rnd-ash/ultimate_nag52/images/egs53.jpg

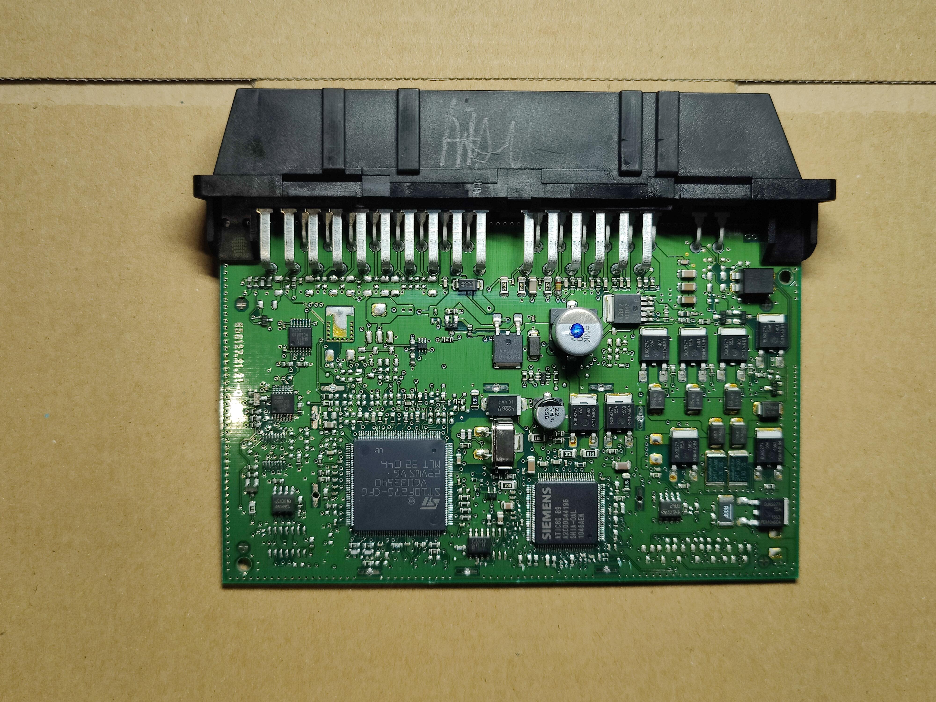
images/egs53.jpg
