rnd-ash/ultimate_nag52/images/egs51.jpg

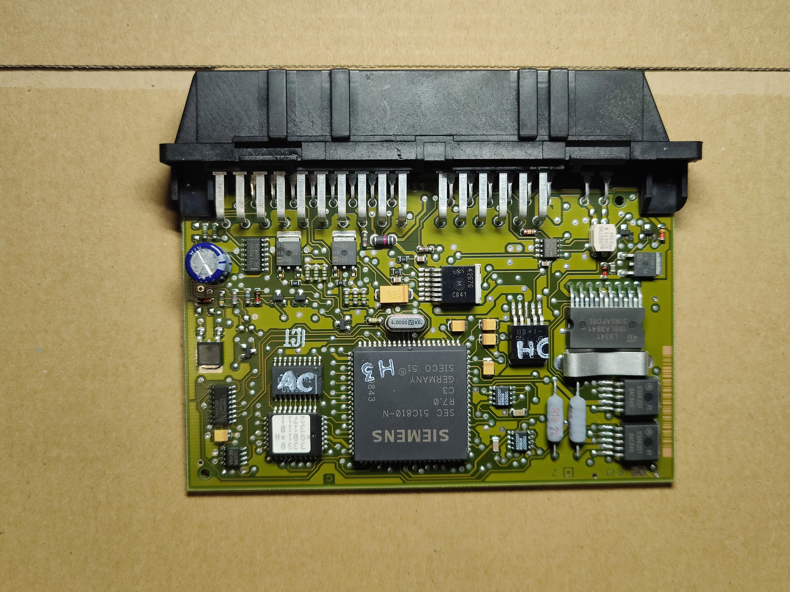
images/egs51.jpg
