rnd-ash/ultimate_nag52/images/egs52.jpg

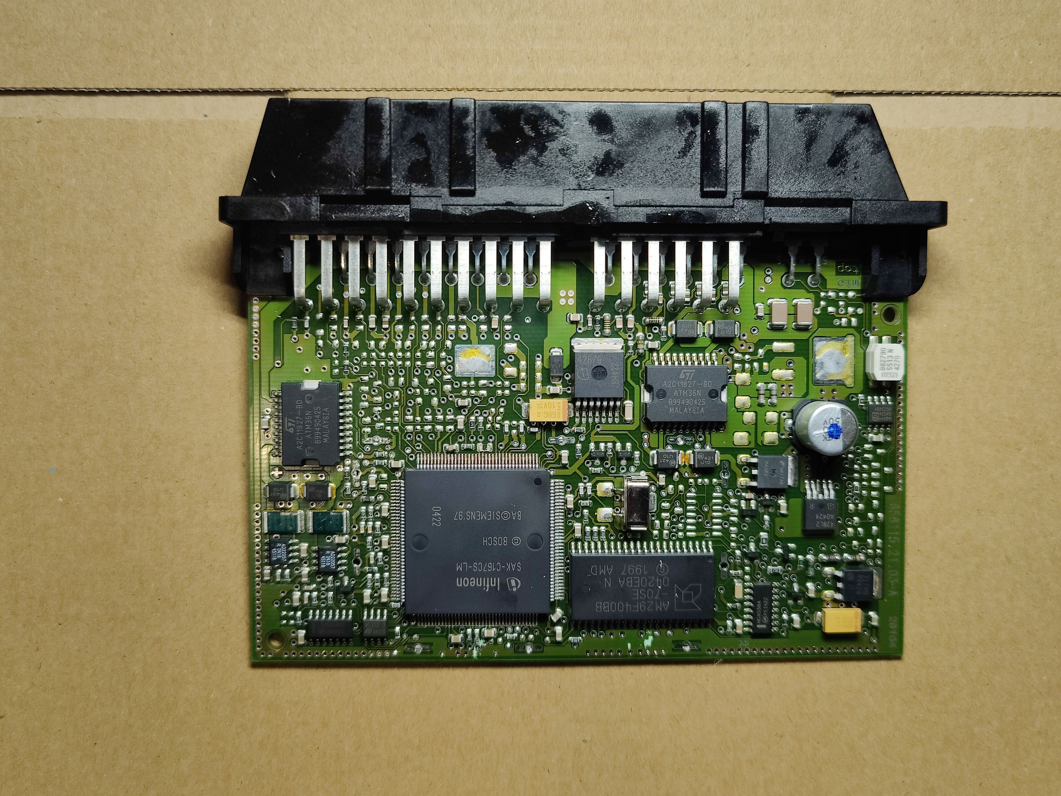
images/egs52.jpg
