rnd-ash/ultimate_nag52/PCB/v1.3 Rev B/bom_v13b.csv

Designator | Footprint | Quantity | Value
C1, C10, C11, C15, C19, C2, C21, C22, C23, C3, C30, C33, C35, C37, C39, C4, C42, C44, C46, C50, C52, C53, C55, C57, C60, C63, C66, C7 | 603 | 28 | 100nF
C12 | CP_Elec_10x10.5 | 1 | 100uF
C13, C16, C24, C51, C58, C8, C9 | 603 | 7 | 10uF
C14, C17, C18, C20 | CP_EIA-3216-18_Kemet-A | 4 | 10uF (Pol.)
C25, C26, C27, C31, C32, C34, C36, C38, C40, C41, C43, C45, C47, C48 | 603 | 14 | 1nF
C28, C29, C49, C54, C56, C59, C62, C65 | 603 | 8 | 10nF
C5, C6 | 603 | 2 | 15pF
D1, D3 | 805 | 2 | LED
D10, D11, D12, D16, D17, D18, D19, D8, D9 | D_SMA | 9 | SS56
D13 | SOT-23 | 1 | BZX84C43
D14 | SOT-23 | 1 | BAV70
D15 | SOT-23 | 1 | BZX84C8V2
D2, D4 | 805 | 2 | LED
D5 | SOT-23 | 1 | BAS40-04
D6 | D_SOD-123 | 1 | BZT52C3V9
D7 | D_SOD-123 | 1 | BZT52C5V6
FL1 | L_CommonModeChoke_TDK_ACM7060 | 1 | SMCM7060-501T
J1 | USB_C_Receptacle_G-Switch_GT-USB-7010ASV | 1 | TYPE-C 16PIN 2MD(073)
J2, J3, J4 | PinHeader_1x03_P2.54mm_Vertical | 3 | Conn_01x03_Pin
LS1 | SFN-12055P | 1 | Speaker
Q1, Q12, Q2 | SOT-23 | 3 | BC817-40
Q10, Q11, Q13, Q14, Q15, Q16, Q6, Q7, Q8, Q9 | TDSON-8-1-thermal-vias | 10 | BSC0702LS
Q3, Q4, Q5 | SOT-23 | 3 | 2N7002
R1, R11, R12, R16, R18, R19, R2, R24, R25, R26, R27, R28, R3, R30, R32, R34, R36, R37, R4, R40, R41, R43, R44, R45, R48, R5, R52, R53, R54, R56, R58, R6, R60, R7 | 603 | 34 | 10K
R10 | 603 | 1 | 22k
R13, R14 | 603 | 2 | 5.1k
R15 | 805 | 1 | 120
R17 | 603 | 1 | 2.2k
R20, R23, R39, R51, R9 | 603 | 5 | 2k
R29, R31, R33, R35, R38, R42 | 603 | 6 | 3k
R46, R47, R55, R57, R59, R61 | 2512 | 6 | 10mΩ
R49, R50 | 603 | 2 | 1K
R8 | 603 | 1 | 47k
SW1 | SW_SPST_TS-1088-xR020 | 1 | TS-1088-AR02016
U1 | TSSOP-24_4.4x7.8mm_P0.65mm | 1 | PCA9535PW,118
U10, U11, U12, U13, U14, U9 | SOT-23-5 | 6 | INA180A3IDBVR
U15 | SOT-23-5 | 1 | AP2112K-3.3
U2 | QFN-24-1EP_4x4mm_P0.5mm_EP2.6x2.6mm | 1 | CP2102N-A02-GQFN24R
U3 | SOT-23-6 | 1 | SRV05-4
U4 | SOIC-8_3.9x4.9mm_P1.27mm | 1 | SN65HVD230
U5 | SOT-223-3_TabPin2 | 1 | AMS1117-3.3
U6 | TO-252-2 | 1 | L78M05ABDT-TR
U7 | ESP32-WROVER-E | 1 | ESP32-WROVER-E-N8R8
U8 | Connector | 1 | connector
