rnd-ash/ultimate_nag52/PCB/v1.3/BOM_1_3.xlsx

Item | Qty | Reference(s) | #manf | Value
1 | 16 | C1, C2, C3, C6, C7, C8, C9, C13, C23, C24, C25, C26, C27, C28, C29, C30 | CC0603KRX7R9BB104 | 100nF
2 | 2 | C4, C5 | CL10B102KB8NNNC | 1nF
3 | 3 | C10, C11, C12 | CL31A106KBHNNNE | 10uF
4 | 2 | C14, C15 | GRM21BR61H106KE43L | 10uF
5 | 2 | C16, C17 | 0603B103K500NT | 10nF
6 | 2 | C18, C20 | TAJA476K006RNJ | 47uF
7 | 2 | C19, C21 | TAJB336K016RNJ | 33uF
8 | 6 | C31, C32, C33, C34, C35, C36 | CL10B223KB8NNNC | 22nF
9 | 2 | D1, D2 | BAS40-04 | BAS40-04
10 | 9 | D3, D4, D5, D11, D12, D13, D14, D15, D16 | 1SMA4753_R1_00001 | 1SMA4753
11 | 1 | D6 | SP0505BAHTG | SP0505BAHT
12 | 3 | D7, D18, D24 | VLMTG1300-GS08 | LED
13 | 1 | D17 | NCD0603O2 | LED
14 | 5 | D8, D19, D20, D22, D23 | E6C0603VGAC1UDA | LED
15 | 1 | D21 | NCD0603B4 | LED
16 | 2 | D9, D10 | SS54 | D_Schottky
17 | 1 | FL1 | ACT1210-101-2P-TL00 | ACT1210-101-2P-TL00
18 | 1 | IC1 | MAX3051ESA+T | MAX3051ESA+T
19 | 1 | IC2 | PCA9535PW,118 | PCA9535PW,118
20 | 2 | J1, J2 |  | Conn_01x03
21 | 2 | L1, L2 | FNR5020S101MT | 100uH
22 | 1 | LS1 | SFN-12055PA6.5 | Speaker
23 | 1 | Q1 | MMBT3904 | MMBT3904
24 | 9 | Q2, Q3, Q4, Q6, Q7, Q8, Q9, Q10, Q11 | IPD031N03LGATMA1 | IPD031N03LGATMA1
25 | 1 | Q5 | UMH3N | UMH3N
26 | 1 | R1 |  | 120
27 | 1 | R2 | AECR0603F1K00K9 | 1K
28 | 22 | R3, R5, R6, R7, R8, R9, R10, R11, R18, R19, R20, R21, R23, R28, R29, R30, R34, R35, R36, R37, R38, R43 | 0603WAF1002T5E | 10K
29 | 1 | R4 | 0603WAF2201T5E | 2.2K
30 | 2 | R12, R15 | 0603WAF2001T5E | 2K
31 | 1 | R13 | CR0603FA2212G | 22.1K
32 | 1 | R14 | 0603WAF4752T5E | 47.5K
33 | 2 | R16, R17 | ERA3AED512V | 5.1K
34 | 1 | R22 | CR0603-FX-5901ELF | 5.9k
35 | 1 | R24 | CR0603-FX-3241ELF | 3.24k
36 | 6 | R25, R26, R27, R31, R32, R33 | LR122WF100MT4E | 0.01
37 | 4 | RN1, RN3, RN5, RN6 | 4D03WGJ0103T5E | 10K
38 | 2 | RN2, RN4 | 4D03WGJ0302T5E | 3K
39 | 1 | SW1 | PTS810SJG250SMTRLFS | SW_DIP_x01
40 | 1 | U1 |  | connector
41 | 1 | U2 | ESP32-WROVER-I | ESP32-WROVER-E
42 | 1 | U3 | CP2102N-A02-GQFN24 | CP2102N-Axx-xQFN24
43 | 1 | U4 | TPAP2112K-3.3TRG1 | AP2112K-3.3
44 | 2 | U5, U6 | TPS5430DDAR | TPS5430DDA
45 | 6 | U7, U8, U9, U10, U11, U12 | INA180A3IDBVR | INA180A3
46 | 1 | USB1 | TYPE-C-2.0-16PIN-SMT-3 | HRO-TYPE-C-31-M-12
