rnd-ash/ultimate_nag52/Addon Boards/1.3 Tcc Zener mod/bom.csv

ID | Name | Designator | Footprint | Quantity | Manufacturer Part | Manufacturer | Supplier | Supplier Part | Price | Pins | 3DModel | Contributor | JLCPCB Part Class | link
1 | 10kΩ | R1,R2 | R0603 | 2 | 0603WAF1002T5E | UNI-ROYAL(厚声) | LCSC | C25804 | 0.001 | 2 | R0603 | lcsc | Basic Part | https://www.mouser.in/datasheet/2/447/PYu_RT_1_to_0_01_RoHS_L_11-1669912.pdf
2 | 1kΩ | R3,R4 | R0603 | 2 | 0603WAF1001T5E | UNI-ROYAL(厚声) | LCSC | C21190 | 0.001 | 2 | R0603 | lcsc | Basic Part | https://www.mouser.in/datasheet/2/447/PYu_RT_1_to_0_01_RoHS_L_11-1669912.pdf
3 | 2kΩ | R5 | R0603 | 1 | 0603WAF2001T5E | UNI-ROYAL(厚声) | LCSC | C22975 | 0.001 | 2 | R0603 | lcsc | Basic Part | https://www.mouser.in/datasheet/2/447/PYu_RT_1_to_0_01_RoHS_L_11-1669912.pdf
4 | BZX84C43 | D4 | SOT-23_L2.9-W1.3-P1.90-LS2.4-BR | 1 | BZX84C43 | ST(先科) | LCSC | C118590 | 0.021 | 3 | SOT-23-3P_L2.9-W1.3-H1.0-LS2.4-P0.95 | LCSC | Extended Part | https://item.szlcsc.com/236142.html
5 | BZX84C8V2_C20616331 | U16 | SOT-23_L2.9-W1.3-P1.90-LS2.4-BR | 1 | BZX84C8V2 | HXY MOSFET(华轩阳电子) | LCSC | C20616331 | 0.014 | 3 | SOT-23-3P_L2.9-W1.3-H1.0-LS2.4-P0.95 | lcsc | Extended Part | https://item.szlcsc.com/236142.html
6 | 1SMA4753A_C438371 | D5 | SMA_L4.3-W2.5-LS5.0-RD | 1 | 1SMA4753A | 晶导微电子 | LCSC | C438371 | 0.032 | 2 | SMA_L4.3-W2.5-LS5.0-RD | LCSC | Extended Part | https://atta.szlcsc.com/upload/public/pdf/source/20191021/C437786_3D65CEC0912CC3CA85CA024EBEBBFCE4.pdf
7 | IPD031N03LGATMA1 | U12,U13 | TO-252-2_L6.5-W6.1-P4.56-LS9.9-BR-CW-1 | 2 | Infineon | Infineon | LCSC |  |  | 3 |  | lcsc | Extended Part | https://img.jlc.com/pdf/applyPasteComponent/2021-11-03/119727G/d1c2bc415c4146f883da2df02eb0e505/IRFR9024N.pdf
8 | BAV70_C2841895 | U14 | SOT-23-3_L2.9-W1.4-P1.90-LS2.6-BR | 1 | BAV70 | KODENSHI AUK(光电子) | LCSC | C2841895 | 0.014 | 3 | SOT-23-3_L2.9-W1.4-P1.90-LS2.6-BR | lcsc | Extended Part | https://lcsc.com/eda_search?q=C2841895&%26type=1&ref=editor
9 | 54102-T06-00 | U15,U18,U19,U20,U21 | HDR-TH_1P-P2.54-V-M | 5 | 54102-T06-00 | Amphenol | LCSC | C213182 | 0.02 | 1 | HDR2.54-M-LI-1X1P | LCSC |  | https://item.szlcsc.com/82426.html
10 | 100nF | U17 | C0603 | 1 | FN18X104J500PBG | PSA(信昌电陶) | LCSC | C2836871 | 0.005 | 2 | C0603_L1.6-W0.8-H0.8 | lcsc | Extended Part | https://lcsc.com/eda_search?q=C2836871&%26type=1&ref=editor
11 | BC817-40_C7528930 | U22 | SOT-23-3_L2.9-W1.3-P1.90-LS2.4-BR | 1 | BC817-40 | AM(安美) | LCSC | C7528930 | 0.014 | 3 | SOT-23-3P_L2.9-W1.3-H1.0-LS2.4-P0.95 | lcsc | Extended Part | https://www.diodes.com/assets/Package-Files/SOT23.pdf
