rnd-ash/ultimate_nag52/Addon Boards/1.3 Tcc Zener mod/mount_model.stl

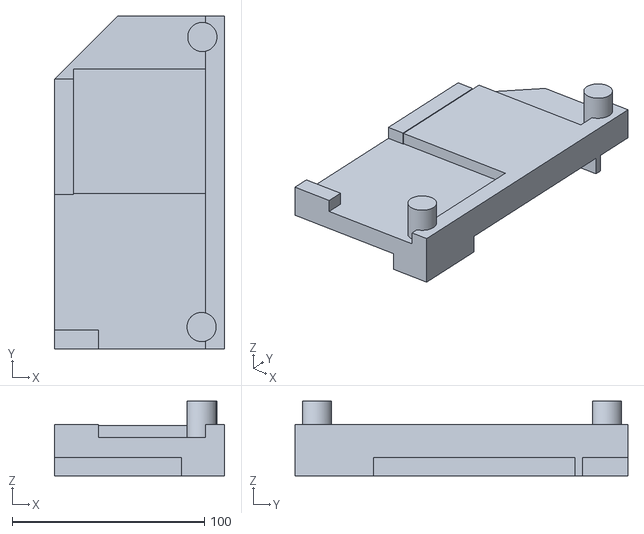
[picture p4: CAD file, 2024-10-16]
Addon Boards/1.3 Tcc Zener mod/mount_model.stl
88.6 x 173.4 x 39.0
