rnd-ash/ultimate_nag52/case_models/case_v3.stl

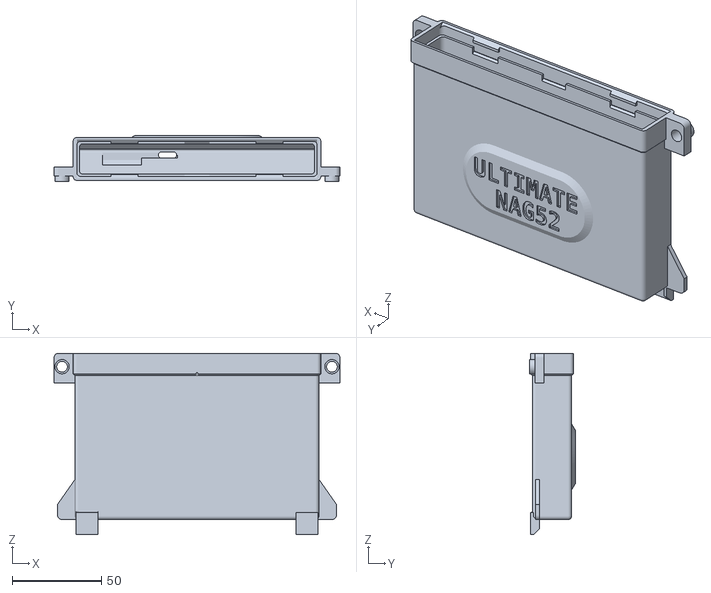
[picture p5: CAD file, 2024-05-09]
case_models/case_v3.stl
160.0 x 25.5 x 101.5
