rnd-ash/ultimate_nag52/(threads)

Thread 1 (2021-02-19):

For what kind of Vehicle this CAN frames code?

iDoka, 2021-02-19:
I would like to add your repo in my collection:
https://github.com/iDoka/awesome-automotive-can-id

Which one Vendor and model related to your code?

rnd-ash, 2021-02-19:
I see you are already have my W203-canbus project.

This is for the same vehicle, so should theoretically work on W203/w209/w211/w219 vehicles.

Check my mbux_port repository for more can data.

iDoka, 2021-02-20:
Ashcon,
thanks for sharing detail!

Closed 2021-02-20.

Thread 2 (2021-12-25):

What does "open implementation" mean as of today?

rusefillc, 2021-12-25:
I was able to find schematics PDF and firmware source code

what is the URL for PCB source? is there a URL for gerbers/bom?

rnd-ash, 2021-12-26:
Currently the BOM / PCB design is private. And I think I will keep it that way for now. This is to ensure people don't make their own PCB designs, run my code on it and then complain when something doesn't work. (I can guarantee assembled units will work so that hopefully eliminates a potential point of failure).

"Open" in this case simply refers to the source code and schematics of the board.

Thread 6 (2022-04-09):

does SH8KA4TB1 need a diode to drive solenoids?

rusefillc, 2022-04-09:
Do you have/need flyback (?) diodes if using SH8KA4TB1 to drive solenoids?

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

rnd-ash, 2022-04-10:
This doesn't look like my tcm, rather I think the one in your image is SSCG's one (standalone without can)

That said, my circuits use a MOSFET and diode, using the exact same setup as the OEM EGS53 TCM (even as far as to use the same automotive grade BUK9277 MOSFETs) . Electrically, it is extremely stable at any pwm (0-4096), and I have not noticed any issues with this circuit in my board I've been using for just under a year now.

rusefillc, 2022-04-10:
Oooops :)

Closed 2022-04-10.

Thread 7 (2022-05-10):

config_app unable to compile

borgonzola, 2022-05-10:
Compiling ecu_diagnostics v0.90.33
error[E0432]: unresolved import `j2534_rust::Loggable`
  --> /home/user/.cargo/registry/src/github.com-1ecc6299db9ec823/ecu_diagnostics-0.90.33/src/hardware/passthru/mod.rs:36:40
   |
36 |     ConnectFlags, FilterType, IoctlID, Loggable, PassthruError, Protocol, RxFlag, TxFlag,
   |                                        ^^^^^^^^ no `Loggable` in the root

   This issue also appears trying to build cloned ecu_diagnostics.

rnd-ash, 2022-05-10:
fixed and closed

Closed 2022-05-10.

Thread 8 (2022-06-09):

A few questions

rocketbob, 2022-06-09:
Interested in using this on my Porsche 996 C4 with 722.6 tiptronic.

What's the timeline for releasing the gerbers?

The current TCU uses an 88 pin connector.  Thoughts on either a breakout board/adapter or an alternate board design with the 88 pin connector footprint added to the PCB?

Thanks
Bob

rocketbob, 2022-06-10:
I believe its a Bosch TCM with a standard Motronic connector.  The upshift/downshift switches connect to the TCM and the gear position is relayed back to the gauge cluster via CAN.

The pinout of the 88 pin connector starts on page 8 of the attached PDF.

[996Tiptronic.pdf](https://github.com/rnd-ash/ultimate_nag52/files/8878836/996Tiptronic.pdf)

rocketbob, 2022-06-27:
I'm certain its a 722.6 as its a 2003 with a 3.6L motor.  ZF versions only shipped with 3.4L motors.  There are Mercedes logos in the castings.

rnd-ash, 2022-06-27:
Well then you have certainly found the wrong ECU. 722.6 ONLY ever comes with a Simens ECU, no other vendor makes the TCM for it, no matter the vehicle.

rnd-ash, 2022-06-27:
Actually, one thing you could potentially do is to check the transmission plug style. It is possible that they have put the internals of the ZF box in the 722.6 casing (Or a common casing). The plug should be able to verify what box you have.

As per what you sent, the ZF box should have a connector like this:
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

Where as the 722.6's connect is as follows:
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

you can see they are completely different connector pin setup

rocketbob, 2022-06-28:
Heres's a photo of the transmission when I had the motor out of the car.  On the side it clearly says Mercedes Benz.

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
.

stukodotnet, 2022-07-05:
Thats the 722.6 connector just above the half-shaft flange. With the off-white/yellowed plastic ring around it.  I don't know anything about the "Tiptronic" other than it did use a 722.6 but it drives it in a semi-auto way. So it could possibly have a different TCU than the Siemens. Can you trace that piece of loom back to the TCU in the car?

ooojupel, 2023-12-01:
Hello. I own an old w124 with OM606 turbodiesel with mechanical IP. Currently installed 722.6 on the Ole Fejer controller (with egs 51 non can shifter). I really want to try your controller for some reasons, if is it possible to add an analog input for signals of engine speed, throttle position, temperature? As i can see, there is free IO 1_3-IO1_7 GPIO Expander inputs, or it for discret signal and esp32 have free gpio too? I can make the PCB myself.
My car has abs (esp) W203 the same like crossfire, W209, with egs52 layer, but not connected by CAN, only abs function. Is it possible to also add an engine identifier to CAN for ESP operation?

Thread 10 (2022-07-10):

Stand Alone TCU?

GreJef04, 2022-07-10:
I am interested in using this as a stand alone for swapping a 722.6 into my W124 with an OM606. Is this a viable option?

I realize, usually there is some fuelling cut that goes on between shifts to make it easier on the transmission. How hard would it be to allow the TCU to operate as a boost controller as well? If I could get it to read boost, and modulate a couple vacuum solenoids it could modulate the fuelling to allow for cleaner shifts. Obviously the W124 is not an OBD2 vehicle.

GreJef04, 2022-07-10:
Just read through your FAQs. Nope, it's not viable as a stand alone for anyone else who comes along.

Closed 2022-07-10.

Thread 14 (2022-12-18):

Missing part.

Horiibence, 2022-12-18:
Hi,
i looking for a part like this to my PCB, but i can't find an alternative part. Can you help me found one. Thank you so much!
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

Closed 2022-12-25.
