rnd-ash/ultimate_nag52/PCB/v1.3 Rev B/schematics_v13b.pdf

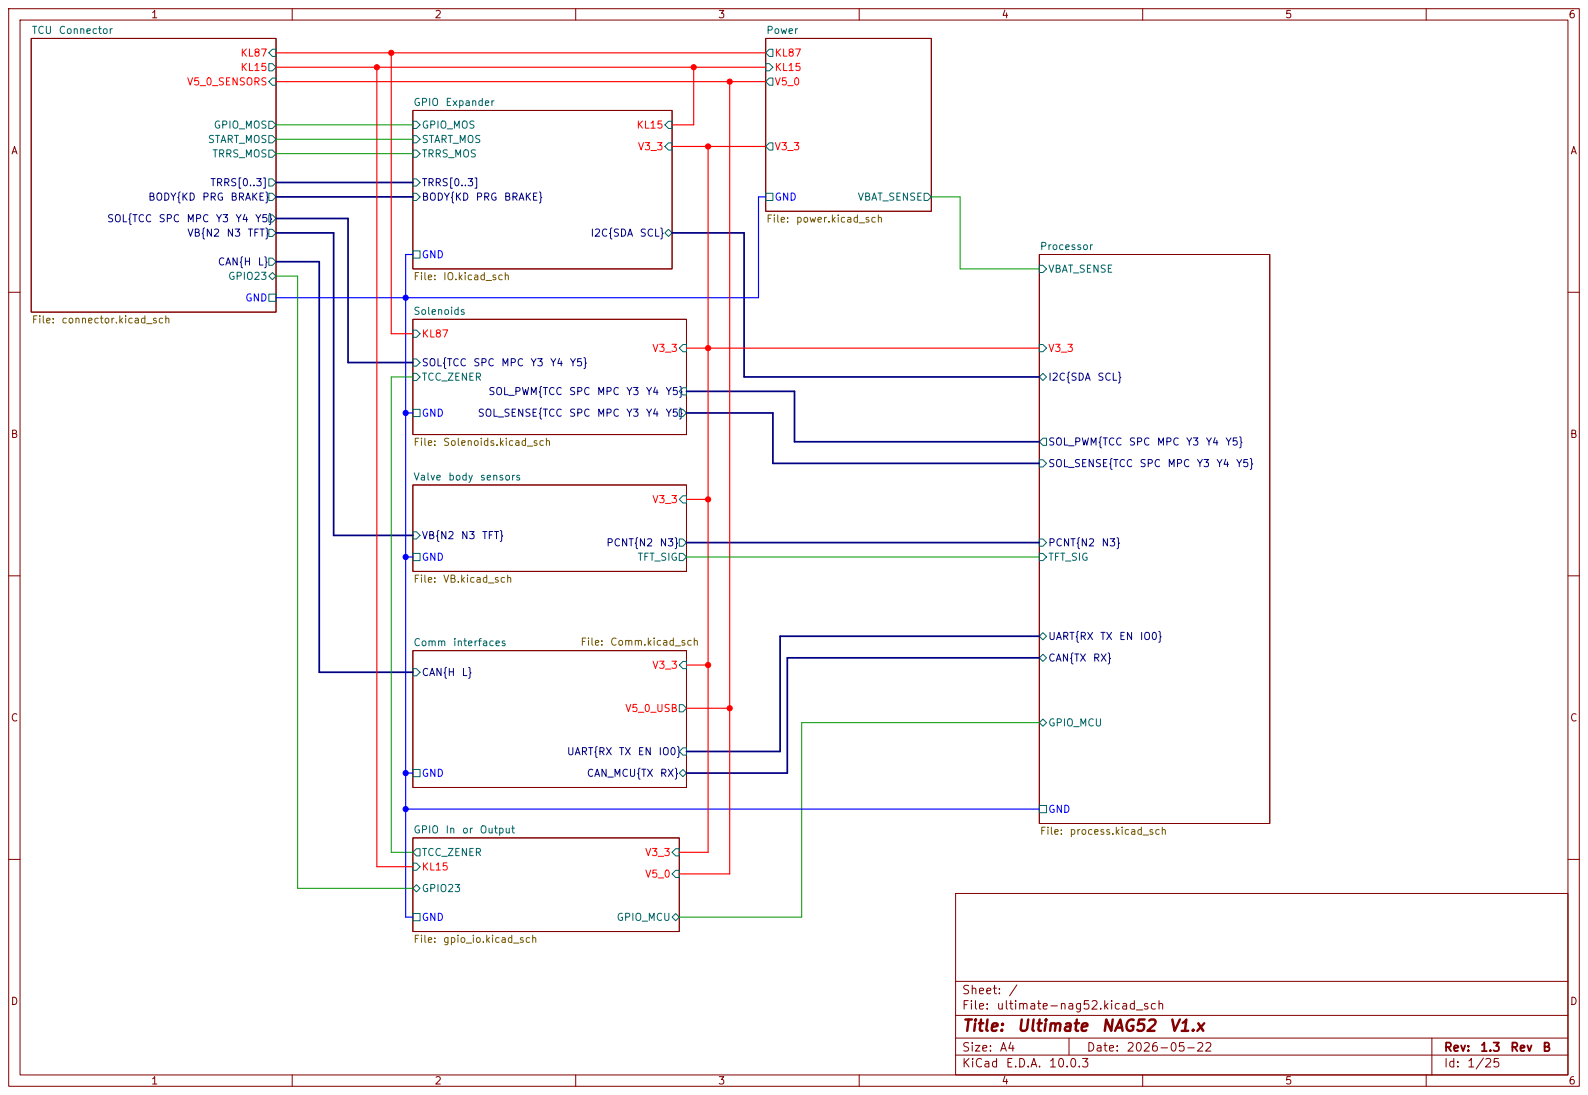
[picture p6: page 1]

V5_0_SENSORS KL15 GPIO23 GPIO_MOS
TRRS[0..3] GPIO Expander File: IO.kicad_sch CAN{H L} GND

TRRS_MOS BODY{KD PRG BRAKE}

SOL{TCC SPC MPC Y3 Y4 Y5}

SOL_SENSE{TCC SPC MPC Y3 Y4 Y5} TFT_SIG UART{RX TX EN IO0} VBAT_SENSE Processor File: process.kicad_sch GND
GND

Solenoids File: Solenoids.kicad_sch GND

SOL{TCC SPC MPC Y3 Y4 Y5} TCC_ZENER

V5_0_USB UART{RX TX EN IO0}

GPIO In or Output File: gpio_io.kicad_sch

Size: A4 | Rev: 1.3 Rev B
KiCad E.D.A. 10.0.3 | Id: 1/25

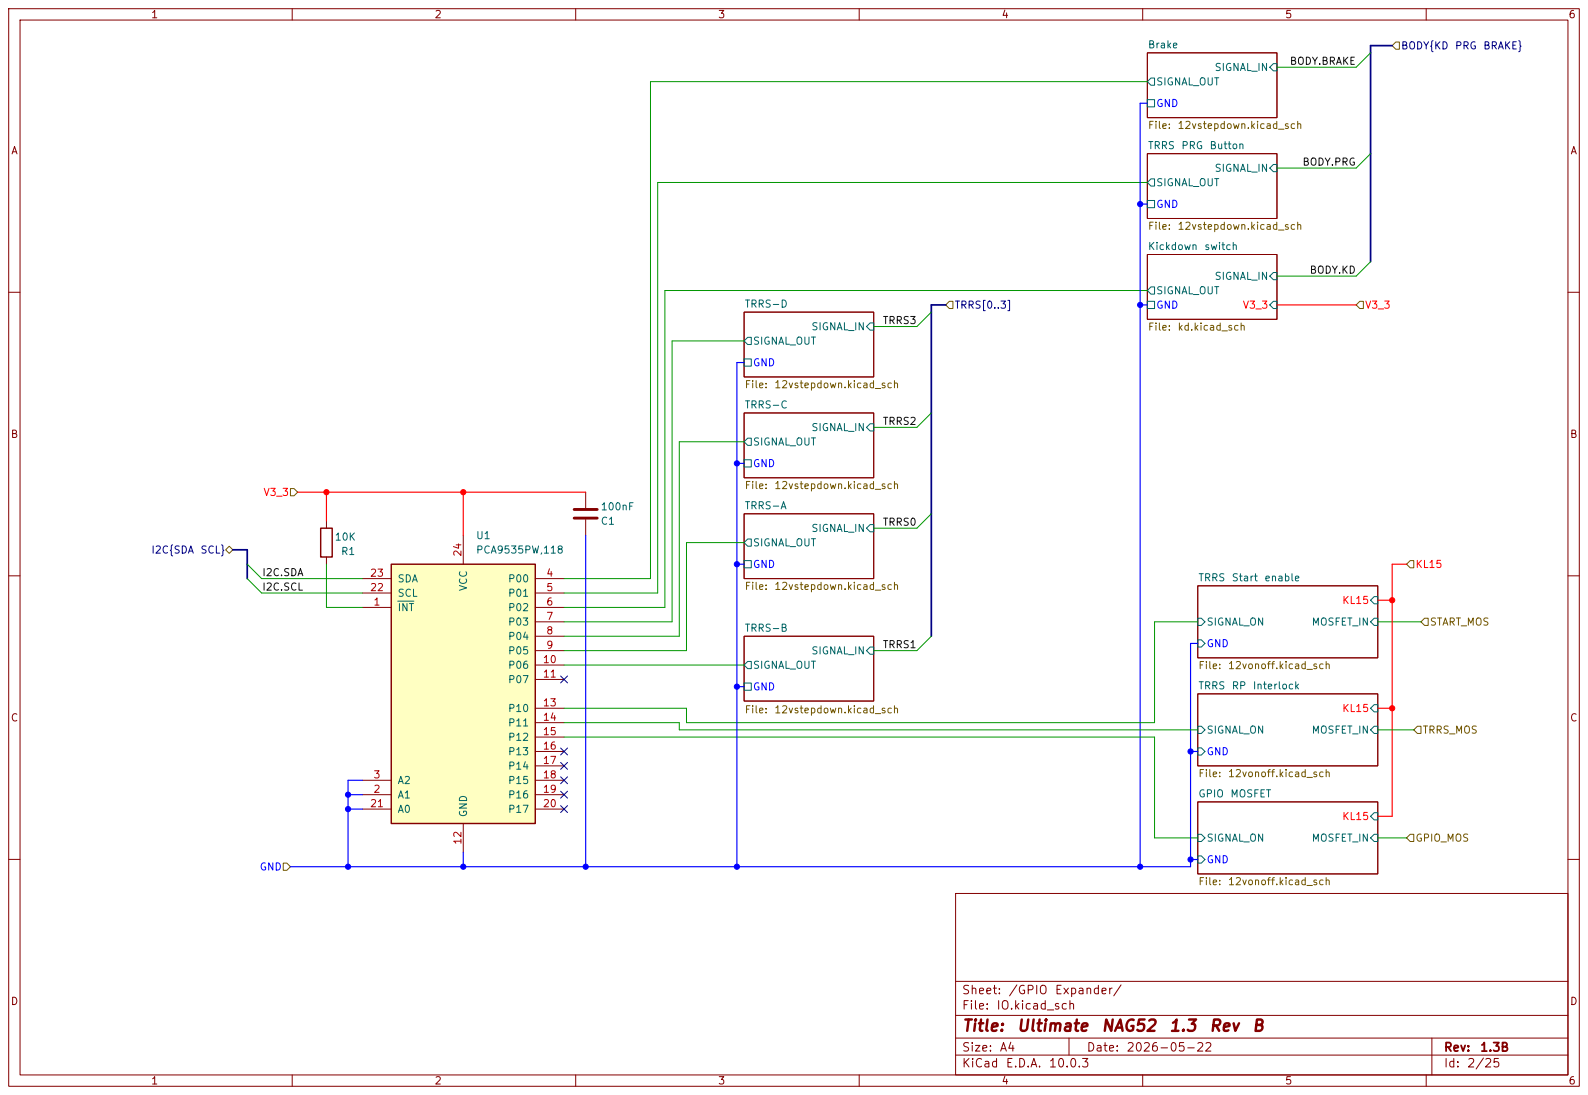
[picture p7: page 2]

BODY{KD PRG BRAKE}

TRRS RP Interlock File: 12vonoff.kicad_sch GND

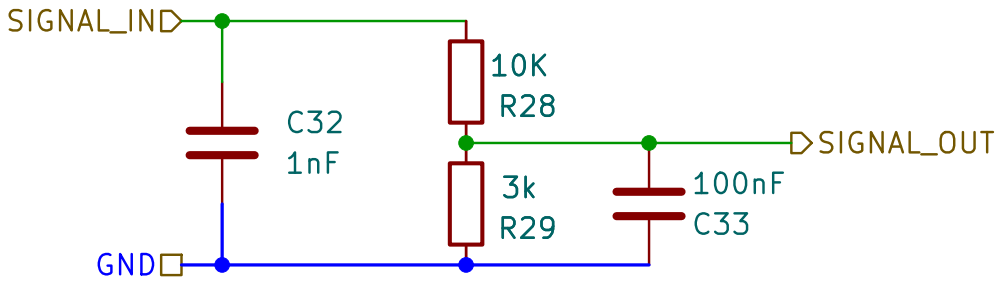
[picture p8: page 3]

Sheet: /GPIO Expander/TRRS-A/
File: 12vstepdown.kicad_sch
Title: Ultimate NAG52 1.3 Rev B

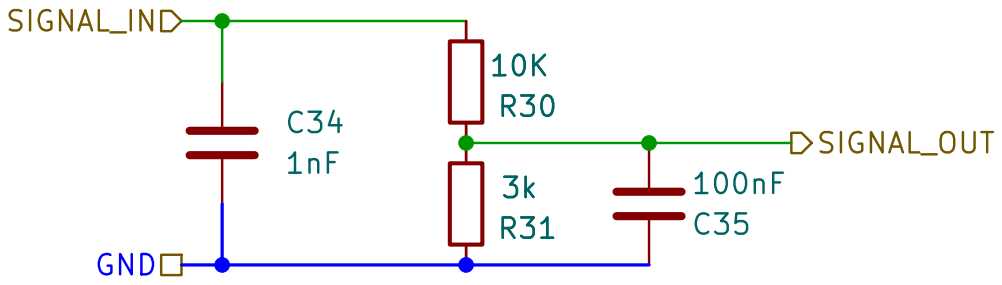
[picture p9: page 4]

Sheet: /GPIO Expander/TRRS-B/
File: 12vstepdown.kicad_sch
Title: Ultimate NAG52 1.3 Rev B

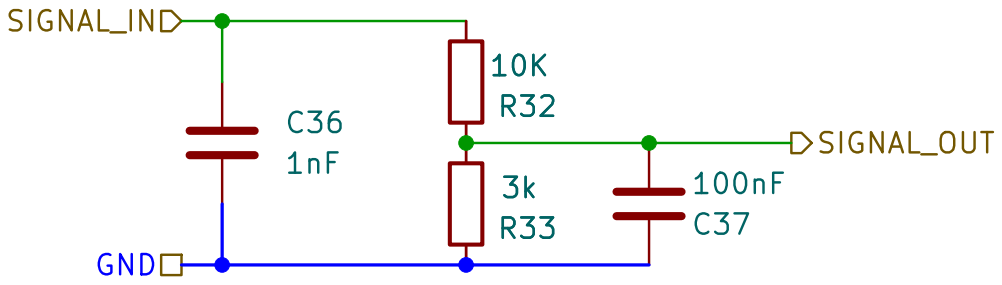
[picture p10: page 5]

Sheet: /GPIO Expander/TRRS-C/
File: 12vstepdown.kicad_sch
Title: Ultimate NAG52 1.3 Rev B

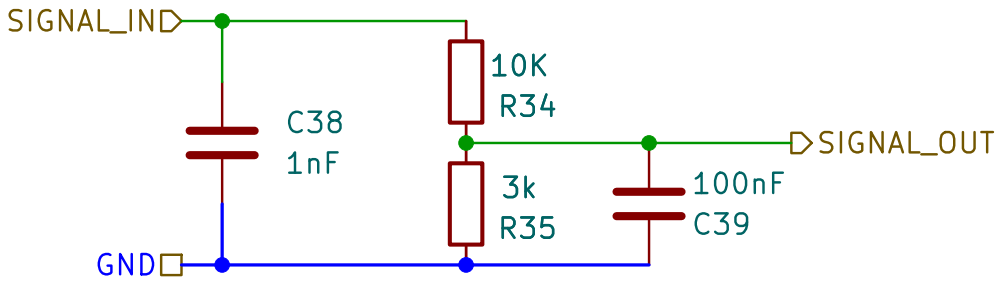
[picture p11: page 6]

Sheet: /GPIO Expander/TRRS-D/
File: 12vstepdown.kicad_sch
Title: Ultimate NAG52 1.3 Rev B

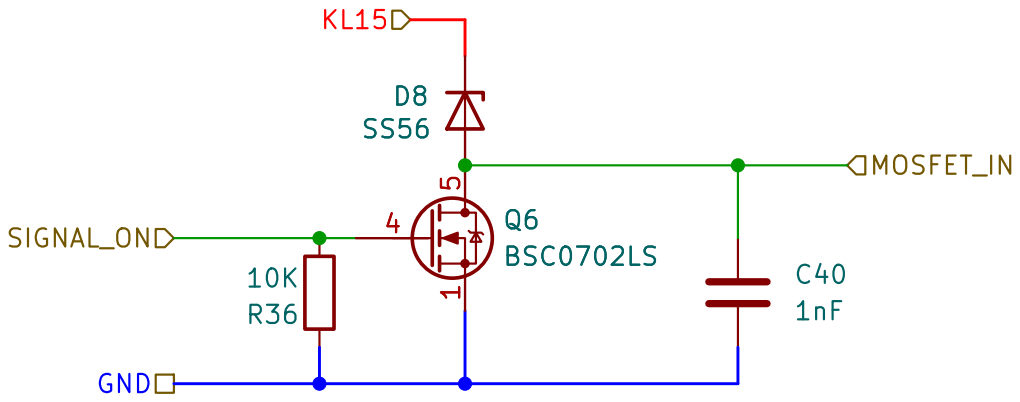
[picture p12: page 7]

Sheet: /GPIO Expander/TRRS Start enable/
File: 12vonoff.kicad_sch
Title: Ultimate NAG52 1.3 Rev B

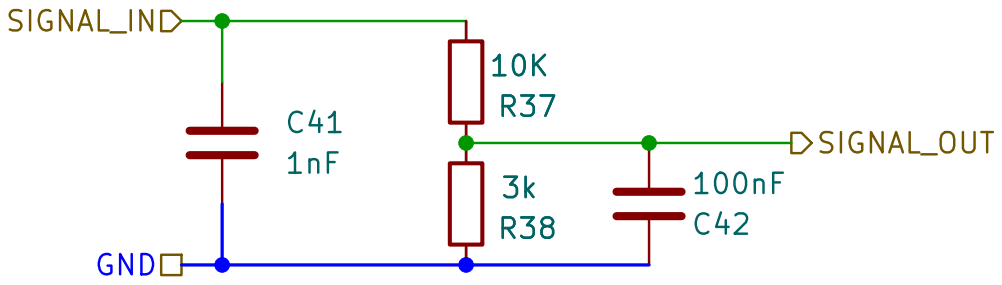
[picture p13: page 8]

Sheet: /GPIO Expander/Brake/
File: 12vstepdown.kicad_sch
Title: Ultimate NAG52 1.3 Rev B

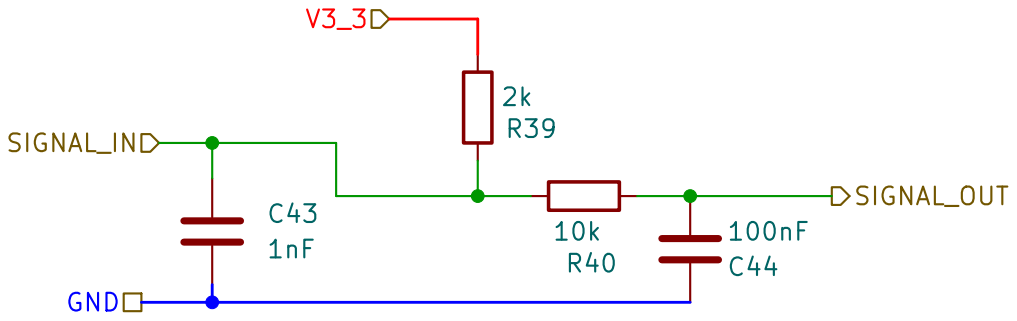
[picture p14: page 9]

Sheet: /GPIO Expander/Kickdown switch/
File: kd.kicad_sch
Title: Ultimate NAG52 1.3 Rev B

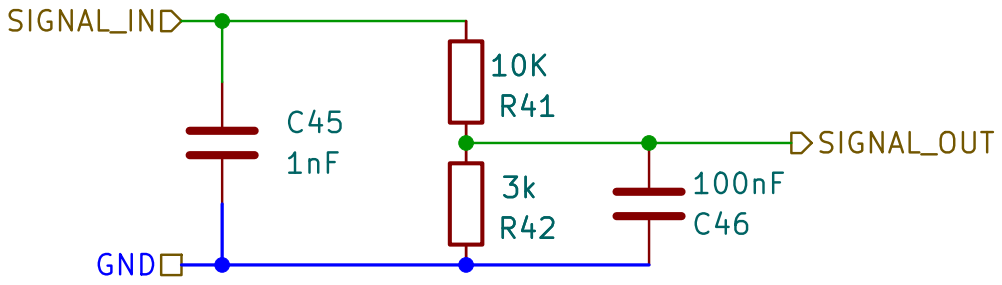
[picture p15: page 10]

Sheet: /GPIO Expander/TRRS PRG Button/
File: 12vstepdown.kicad_sch
Title: Ultimate NAG52 1.3 Rev B

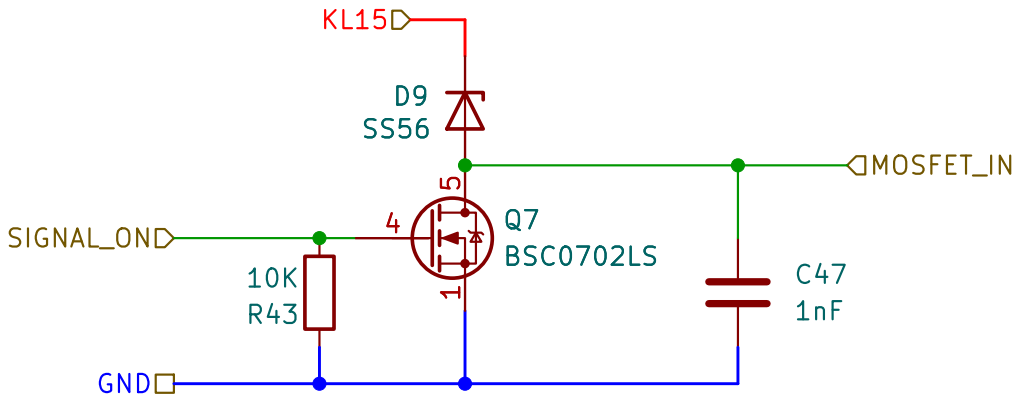
[picture p16: page 11]

Sheet: /GPIO Expander/GPIO MOSFET/
File: 12vonoff.kicad_sch
Title: Ultimate NAG52 1.3 Rev B

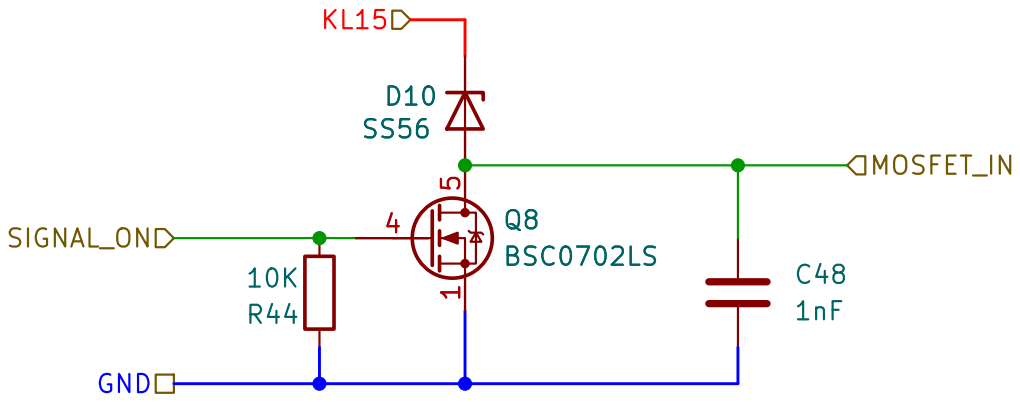
[picture p17: page 12]

Sheet: /GPIO Expander/TRRS RP Interlock/
File: 12vonoff.kicad_sch
Title: Ultimate NAG52 1.3 Rev B

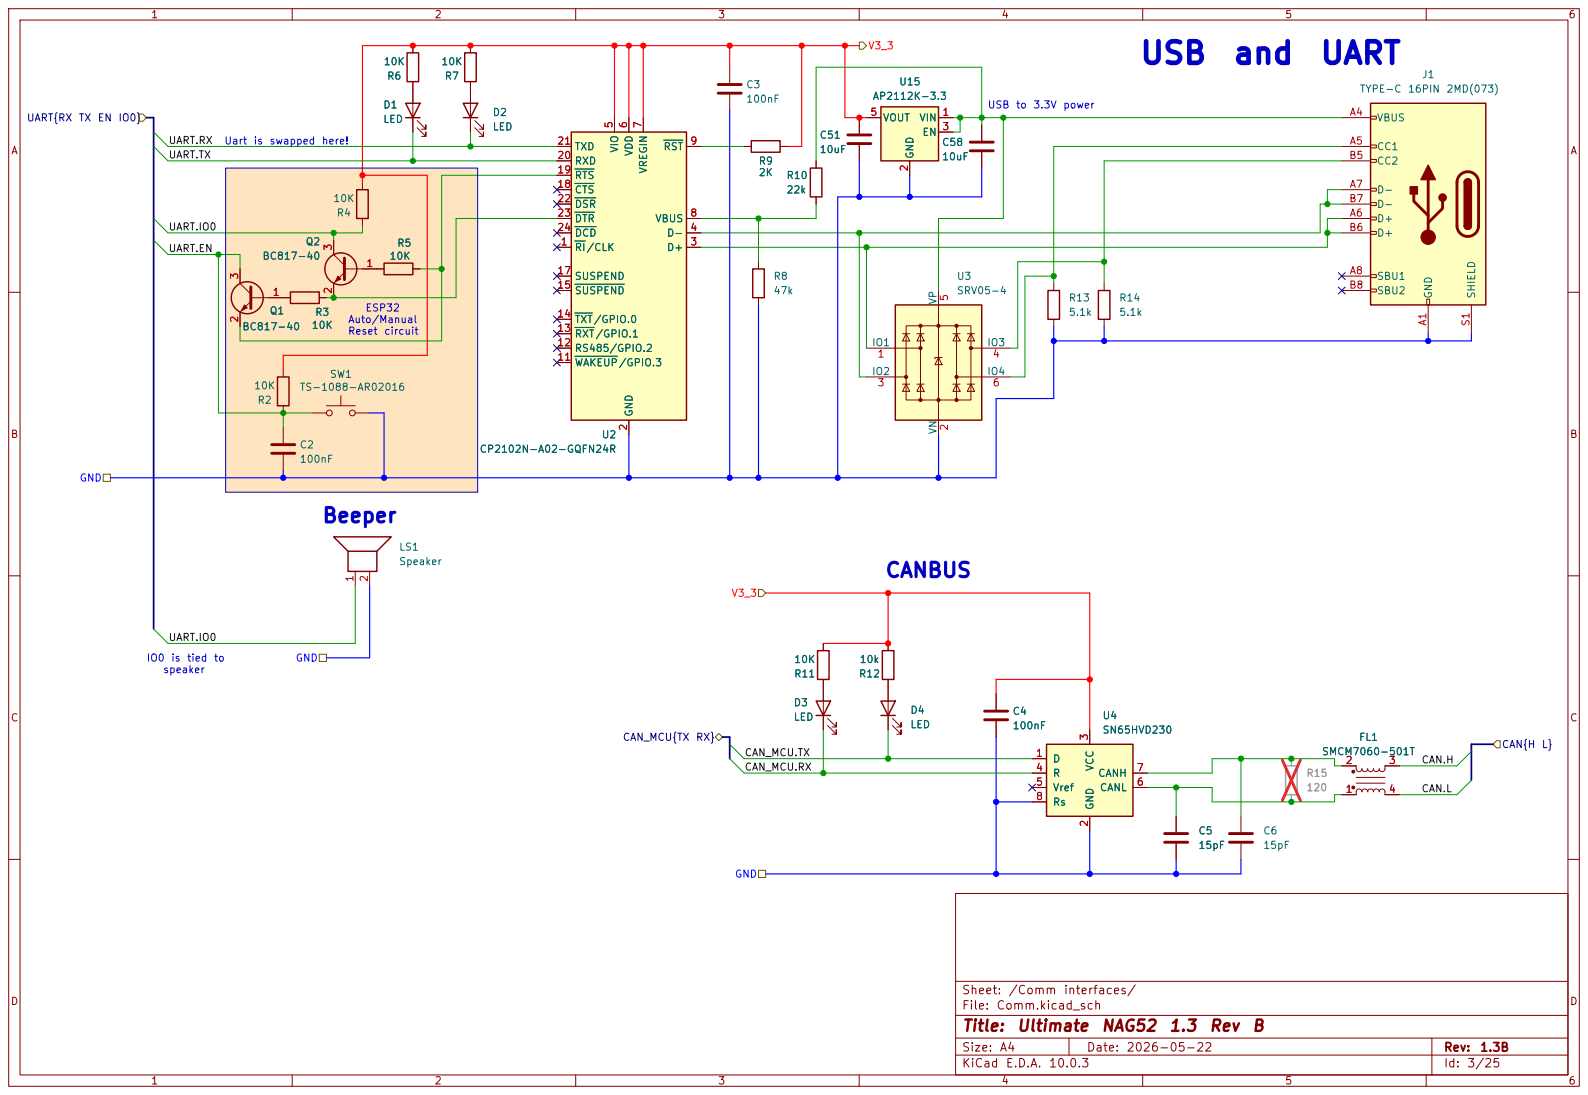
[picture p18: page 13]

SUSPEND 15 SUSPEND 17 CTS 18 RTS 19 RXD 20 TXD 21 DSR 22 DTR 23 DCD 24 R6

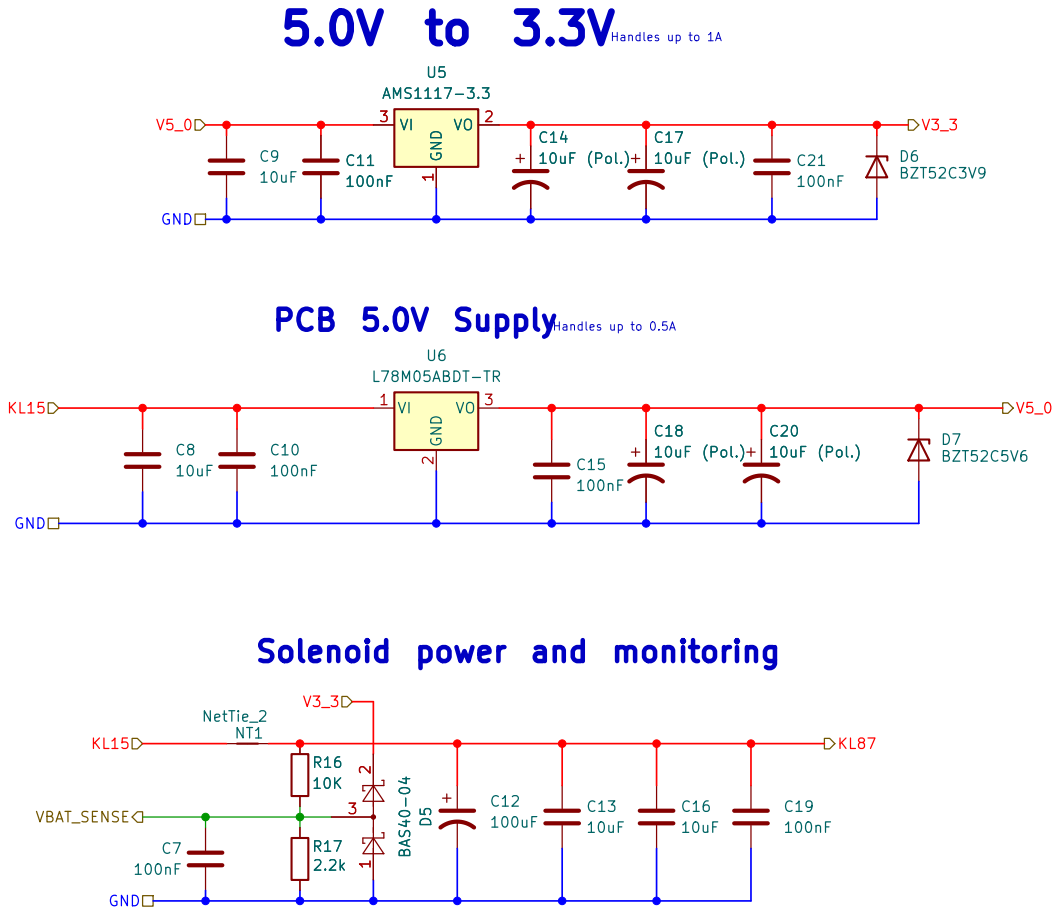
[picture p19: page 14]

PCB 5.0V SupplyHandles up to 0.5A Handles up to 1A Solenoid power and monitoring
AMS1117-3.3 R17
10uF (Pol.) R17
V3_3 GND

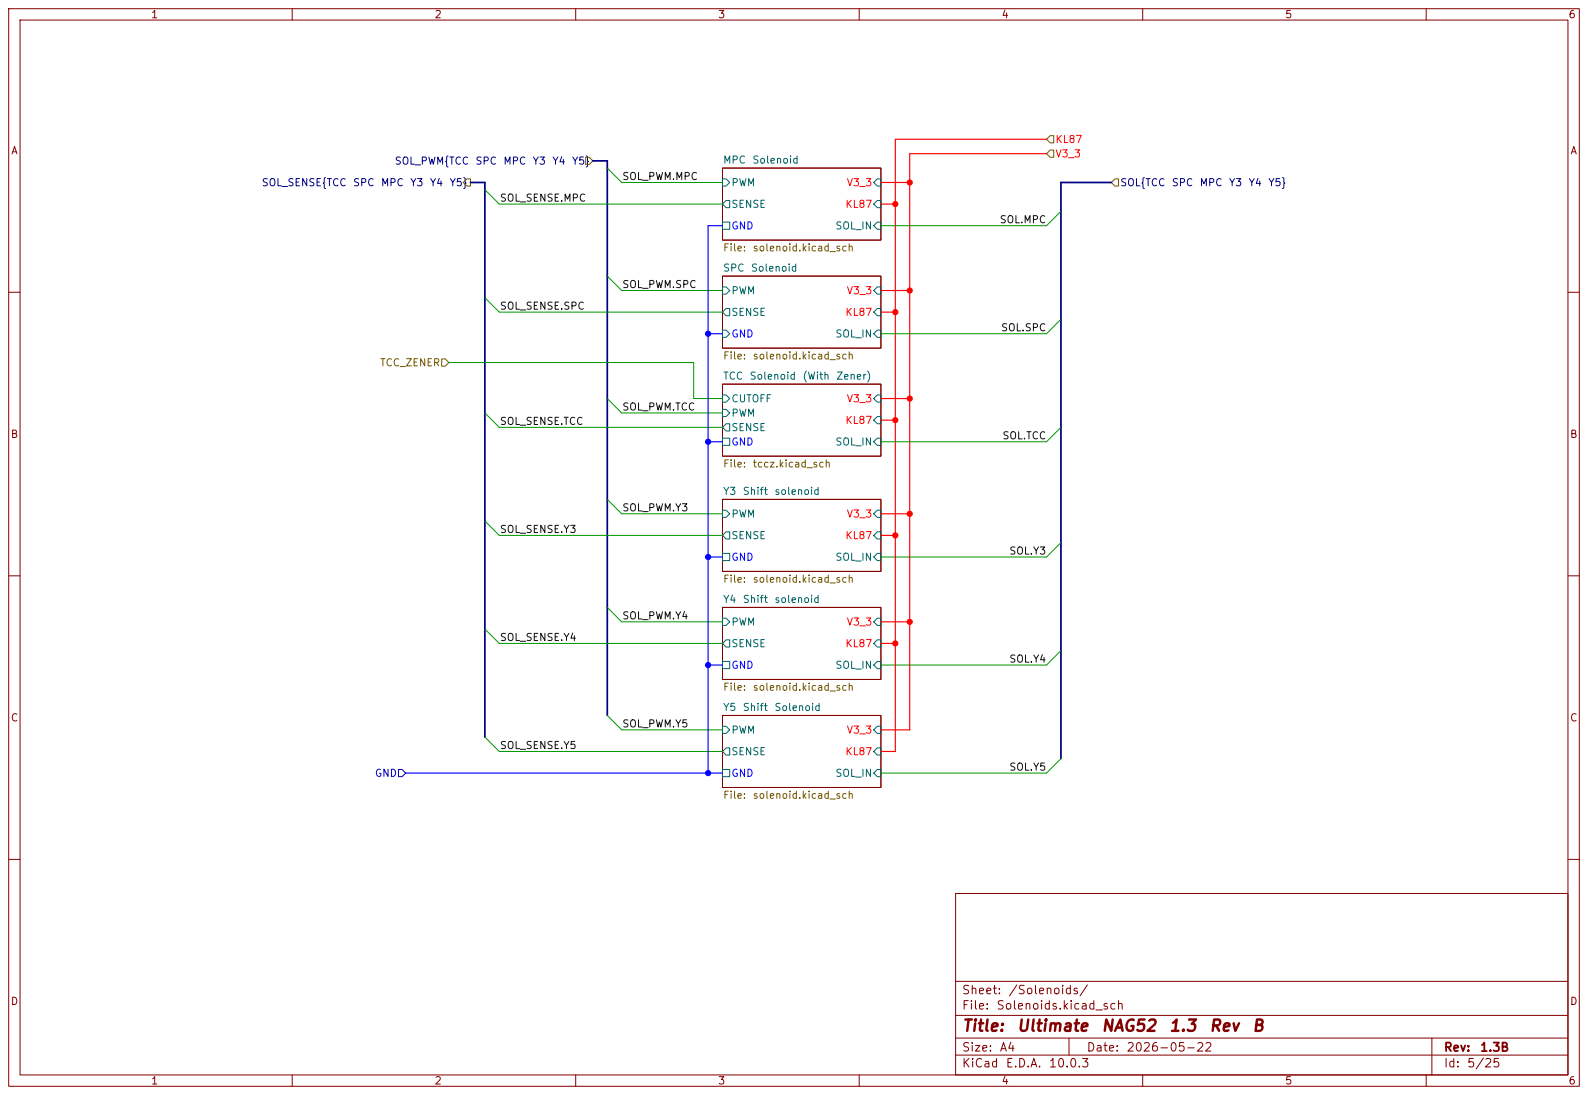
[picture p20: page 15]

SOL{TCC SPC MPC Y3 Y4 Y5} GND

File: solenoid.kicad_sch CUTOFF GND

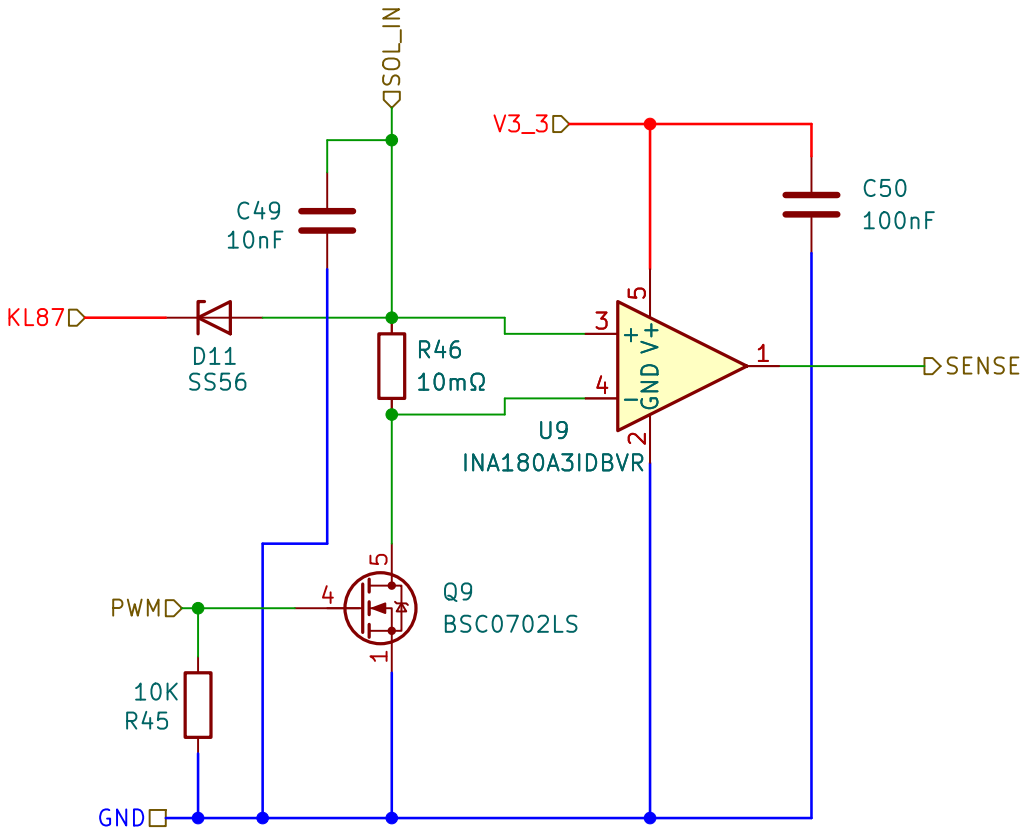
[picture p21: page 16]

Sheet: /Solenoids/MPC Solenoid/
File: solenoid.kicad_sch
Title: Ultimate NAG52 1.3 Rev B

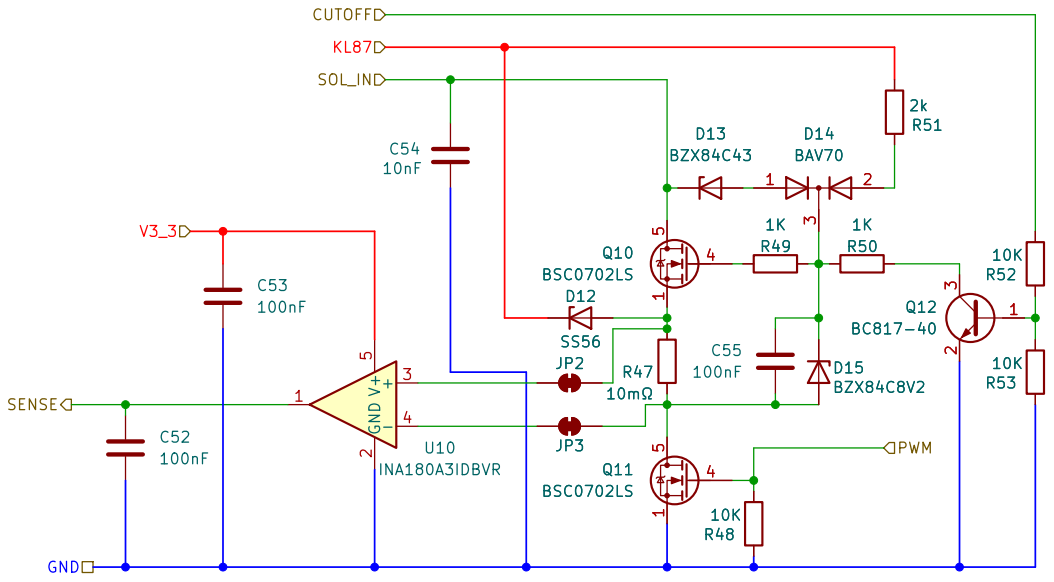
[picture p22: page 17]

Sheet: /Solenoids/TCC Solenoid (With Zener)/
File: tccz.kicad_sch
Title: Ultimate NAG52 1.3 Rev B

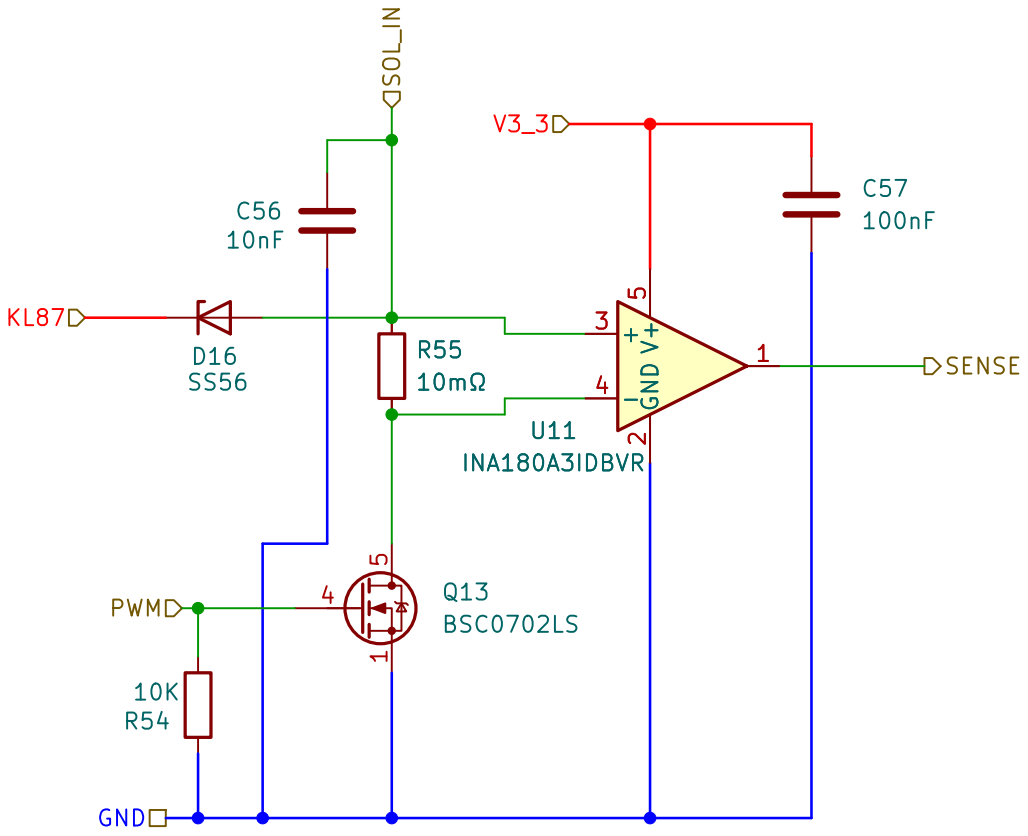
[picture p23: page 18]

Sheet: /Solenoids/Y3 Shift solenoid/
File: solenoid.kicad_sch
Title: Ultimate NAG52 1.3 Rev B

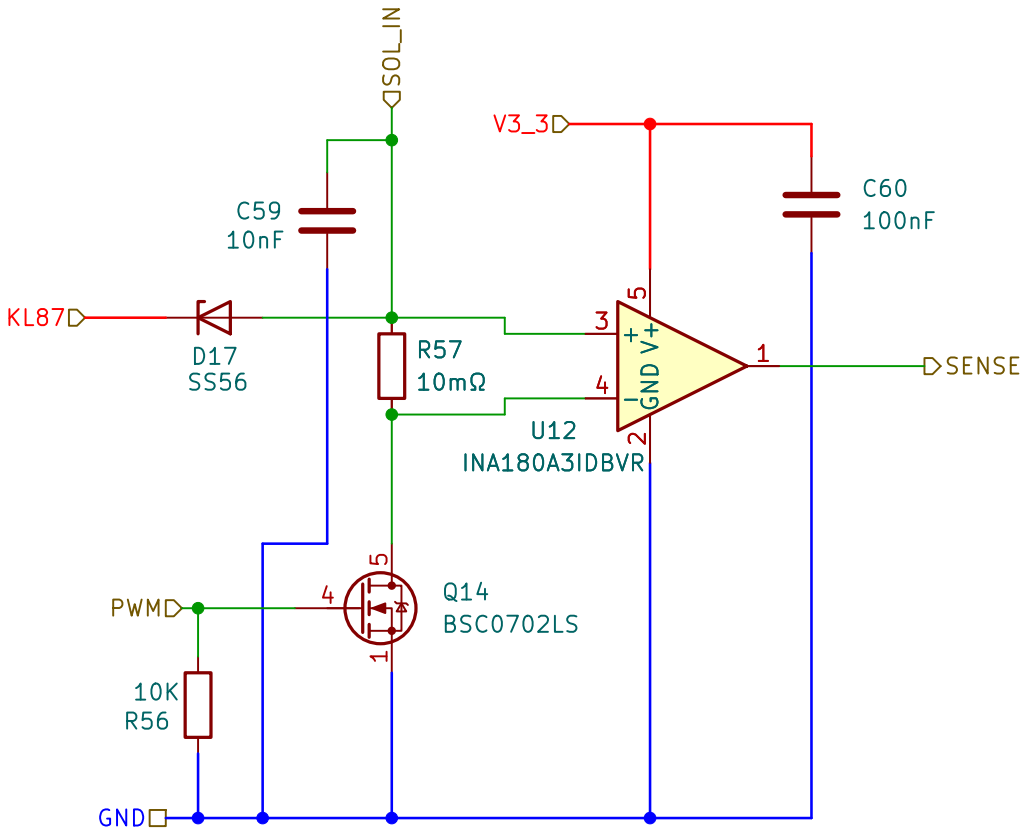
[picture p24: page 19]

Sheet: /Solenoids/Y4 Shift solenoid/
File: solenoid.kicad_sch
Title: Ultimate NAG52 1.3 Rev B

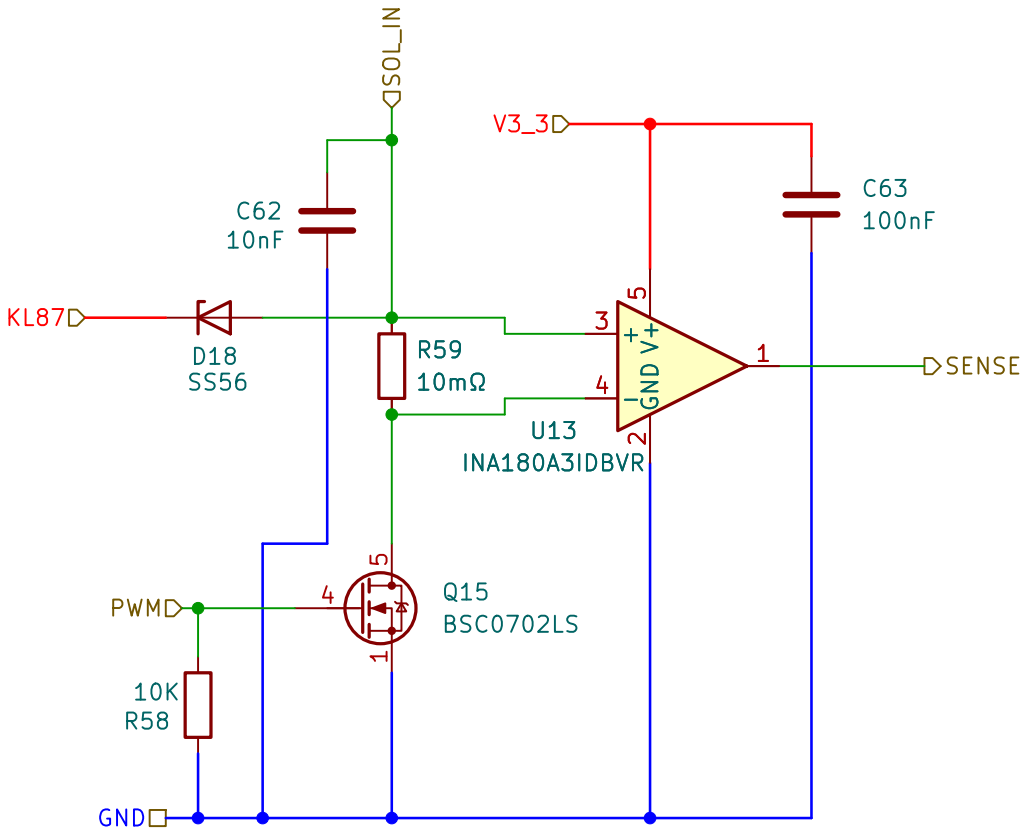
[picture p25: page 20]

Sheet: /Solenoids/Y5 Shift Solenoid/
File: solenoid.kicad_sch
Title: Ultimate NAG52 1.3 Rev B

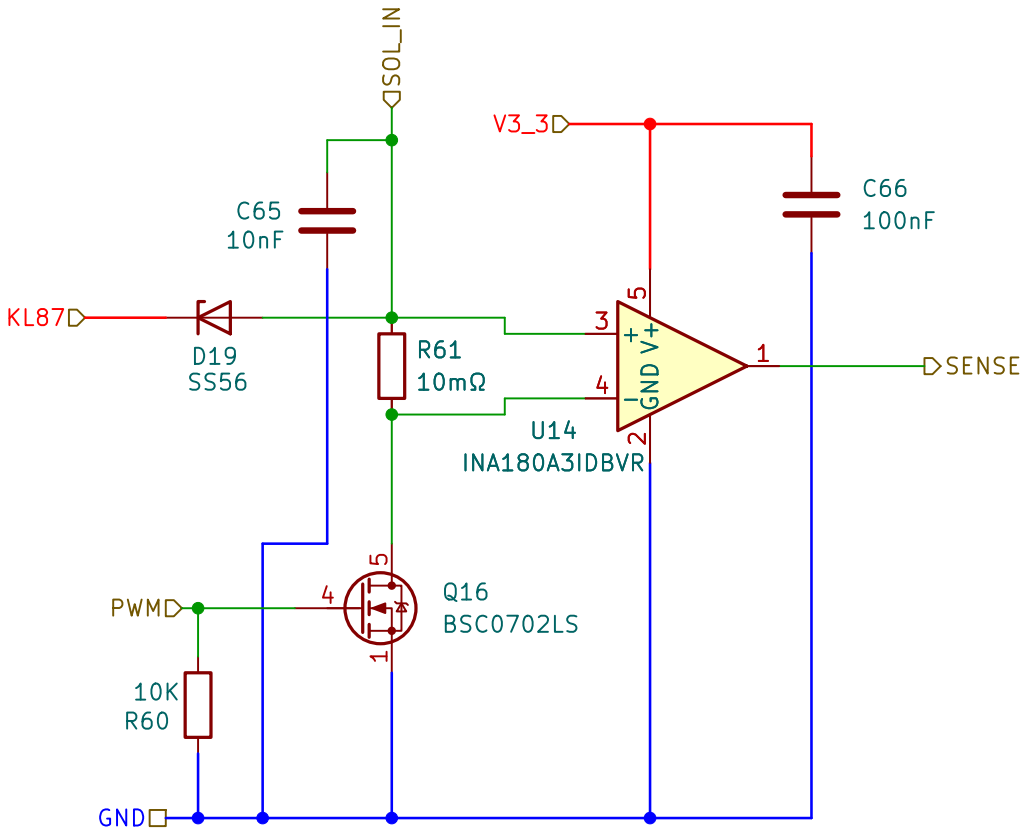
[picture p26: page 21]

Sheet: /Solenoids/SPC Solenoid/
File: solenoid.kicad_sch
Title: Ultimate NAG52 1.3 Rev B

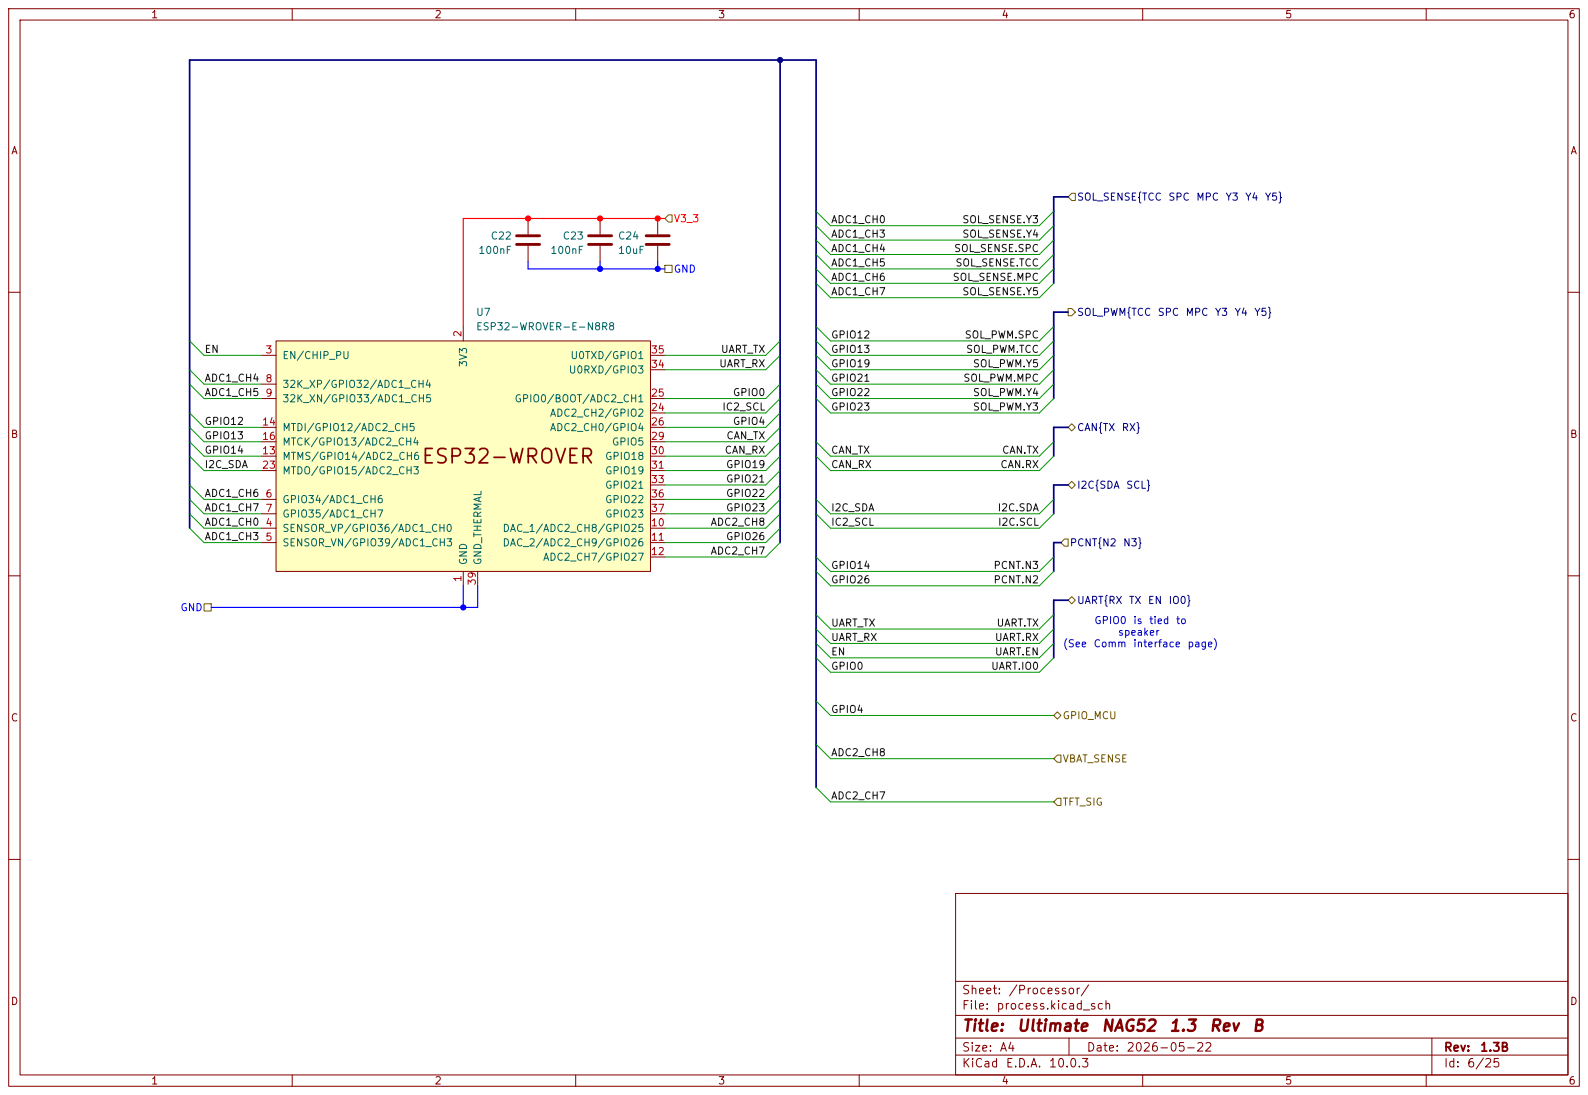
[picture p27: page 22]

SOL_PWM{TCC SPC MPC Y3 Y4 Y5} GND
I2C_SDA EN

(See Comm interface page)

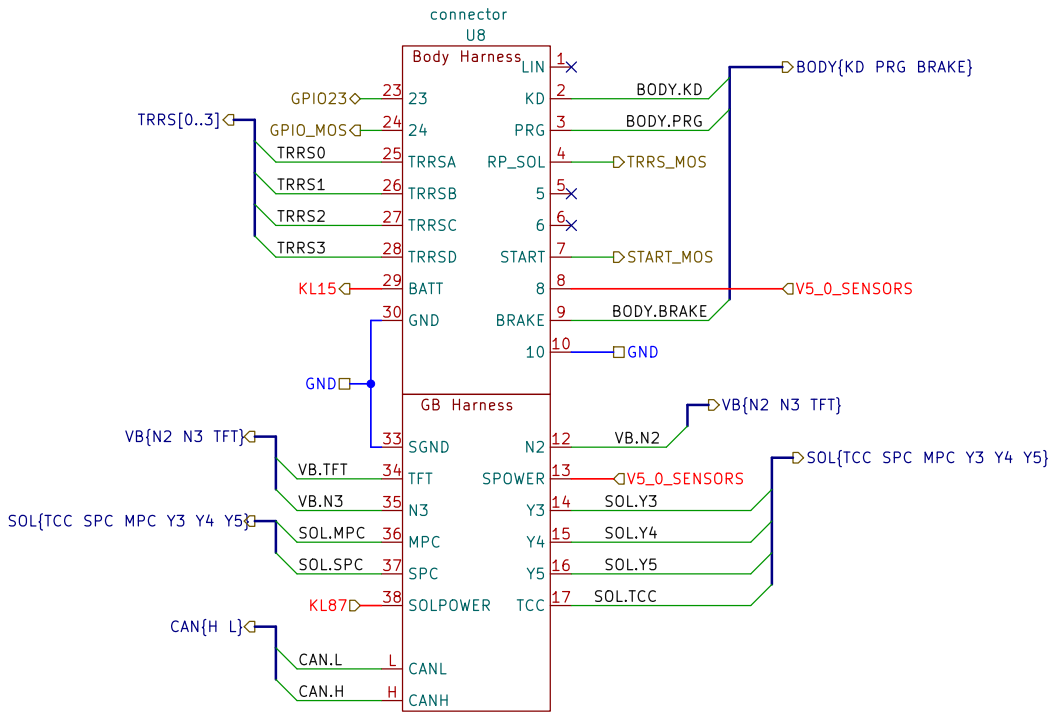
[picture p28: page 23]

Body Harness GB Harness

BODY{KD PRG BRAKE} V5_0_SENSORS

VB{N2 N3 TFT} VB.TFT

SOL{TCC SPC MPC Y3 Y4 Y5}

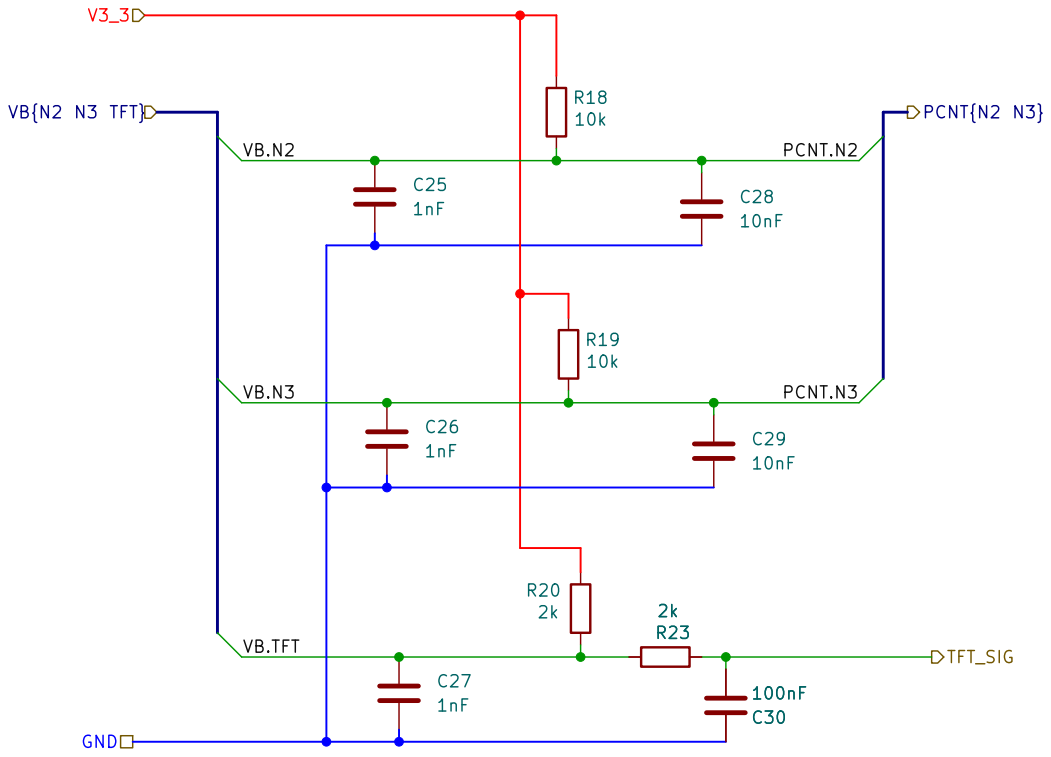
[picture p29: page 24]

Sheet: /Valve body sensors/
File: VB.kicad_sch
Title: Ultimate NAG52 1.3 Rev B

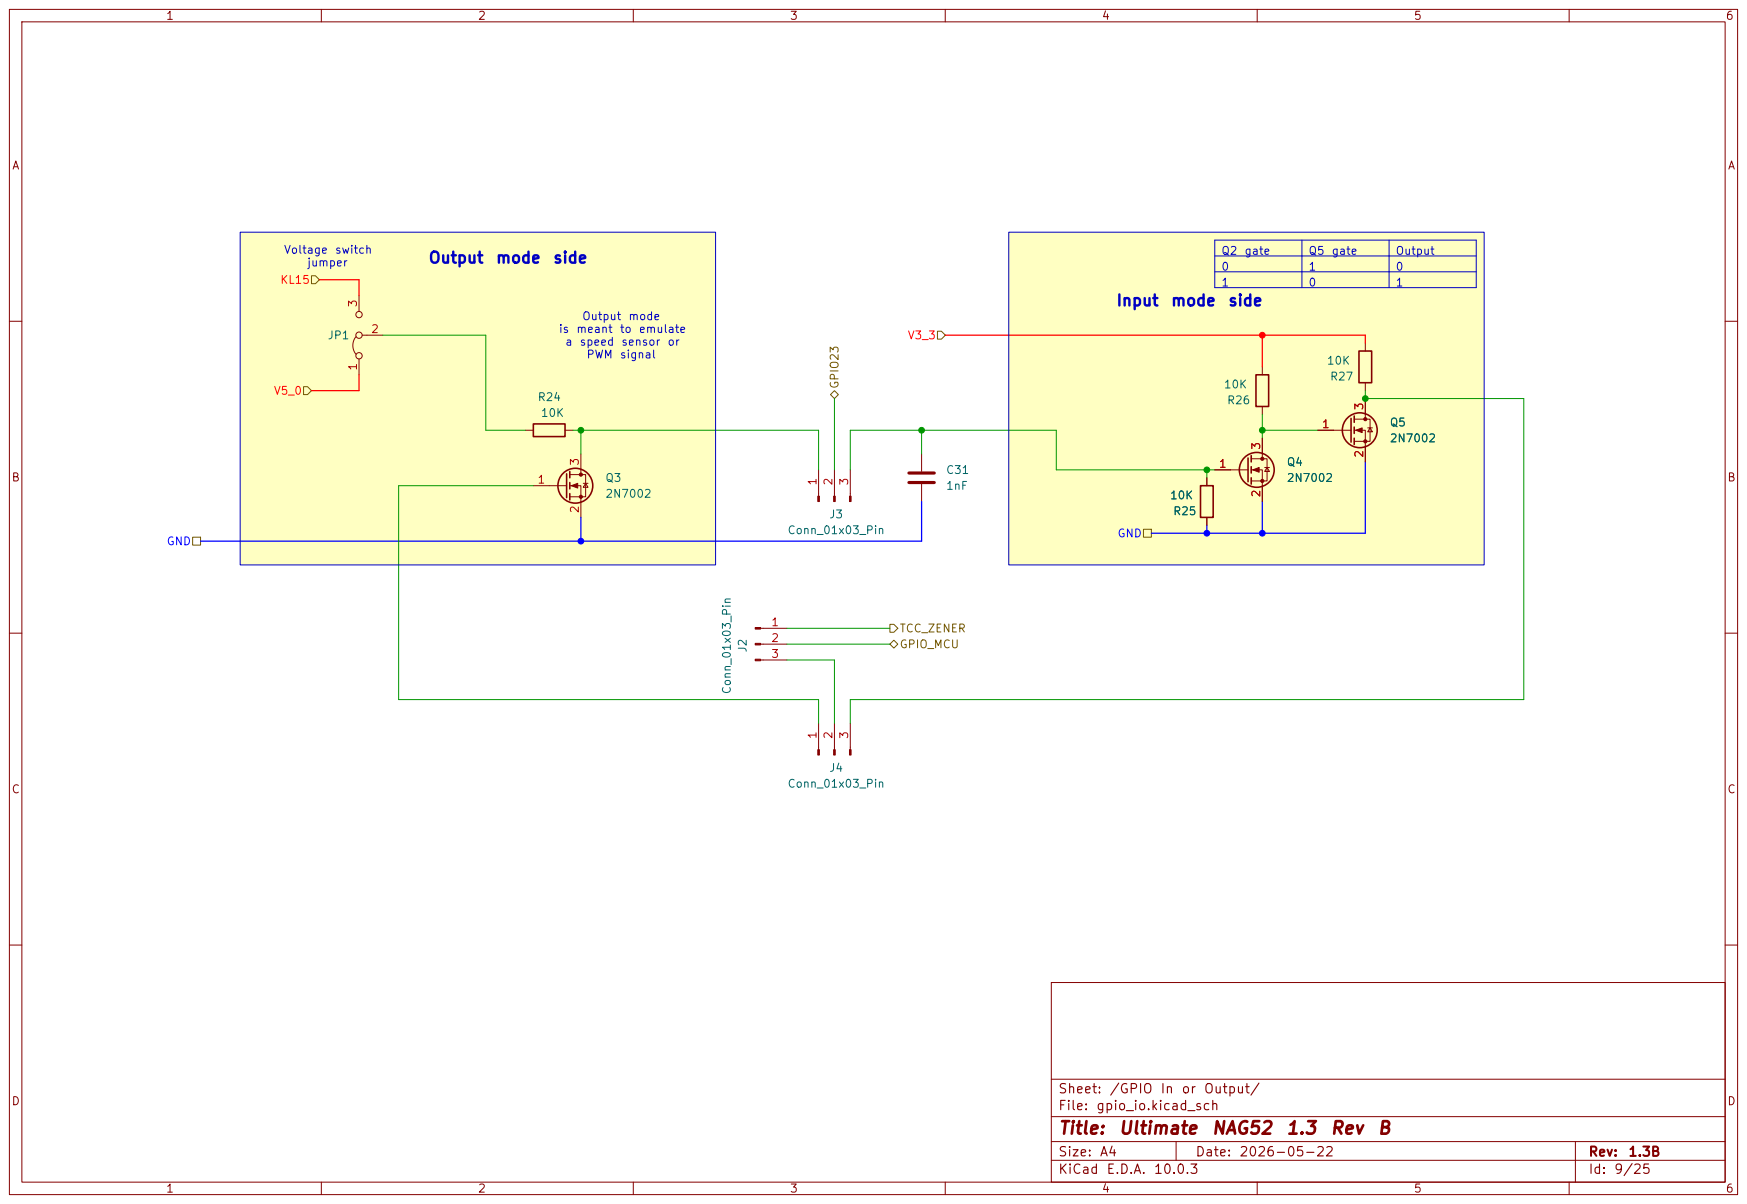
[picture p30: page 25]

Sheet: /GPIO In or Output/
File: gpio_io.kicad_sch
Title: Ultimate NAG52 1.3 Rev B
