rnd-ash/ultimate_nag52/PCB/v1.3/schematics_1.3.pdf

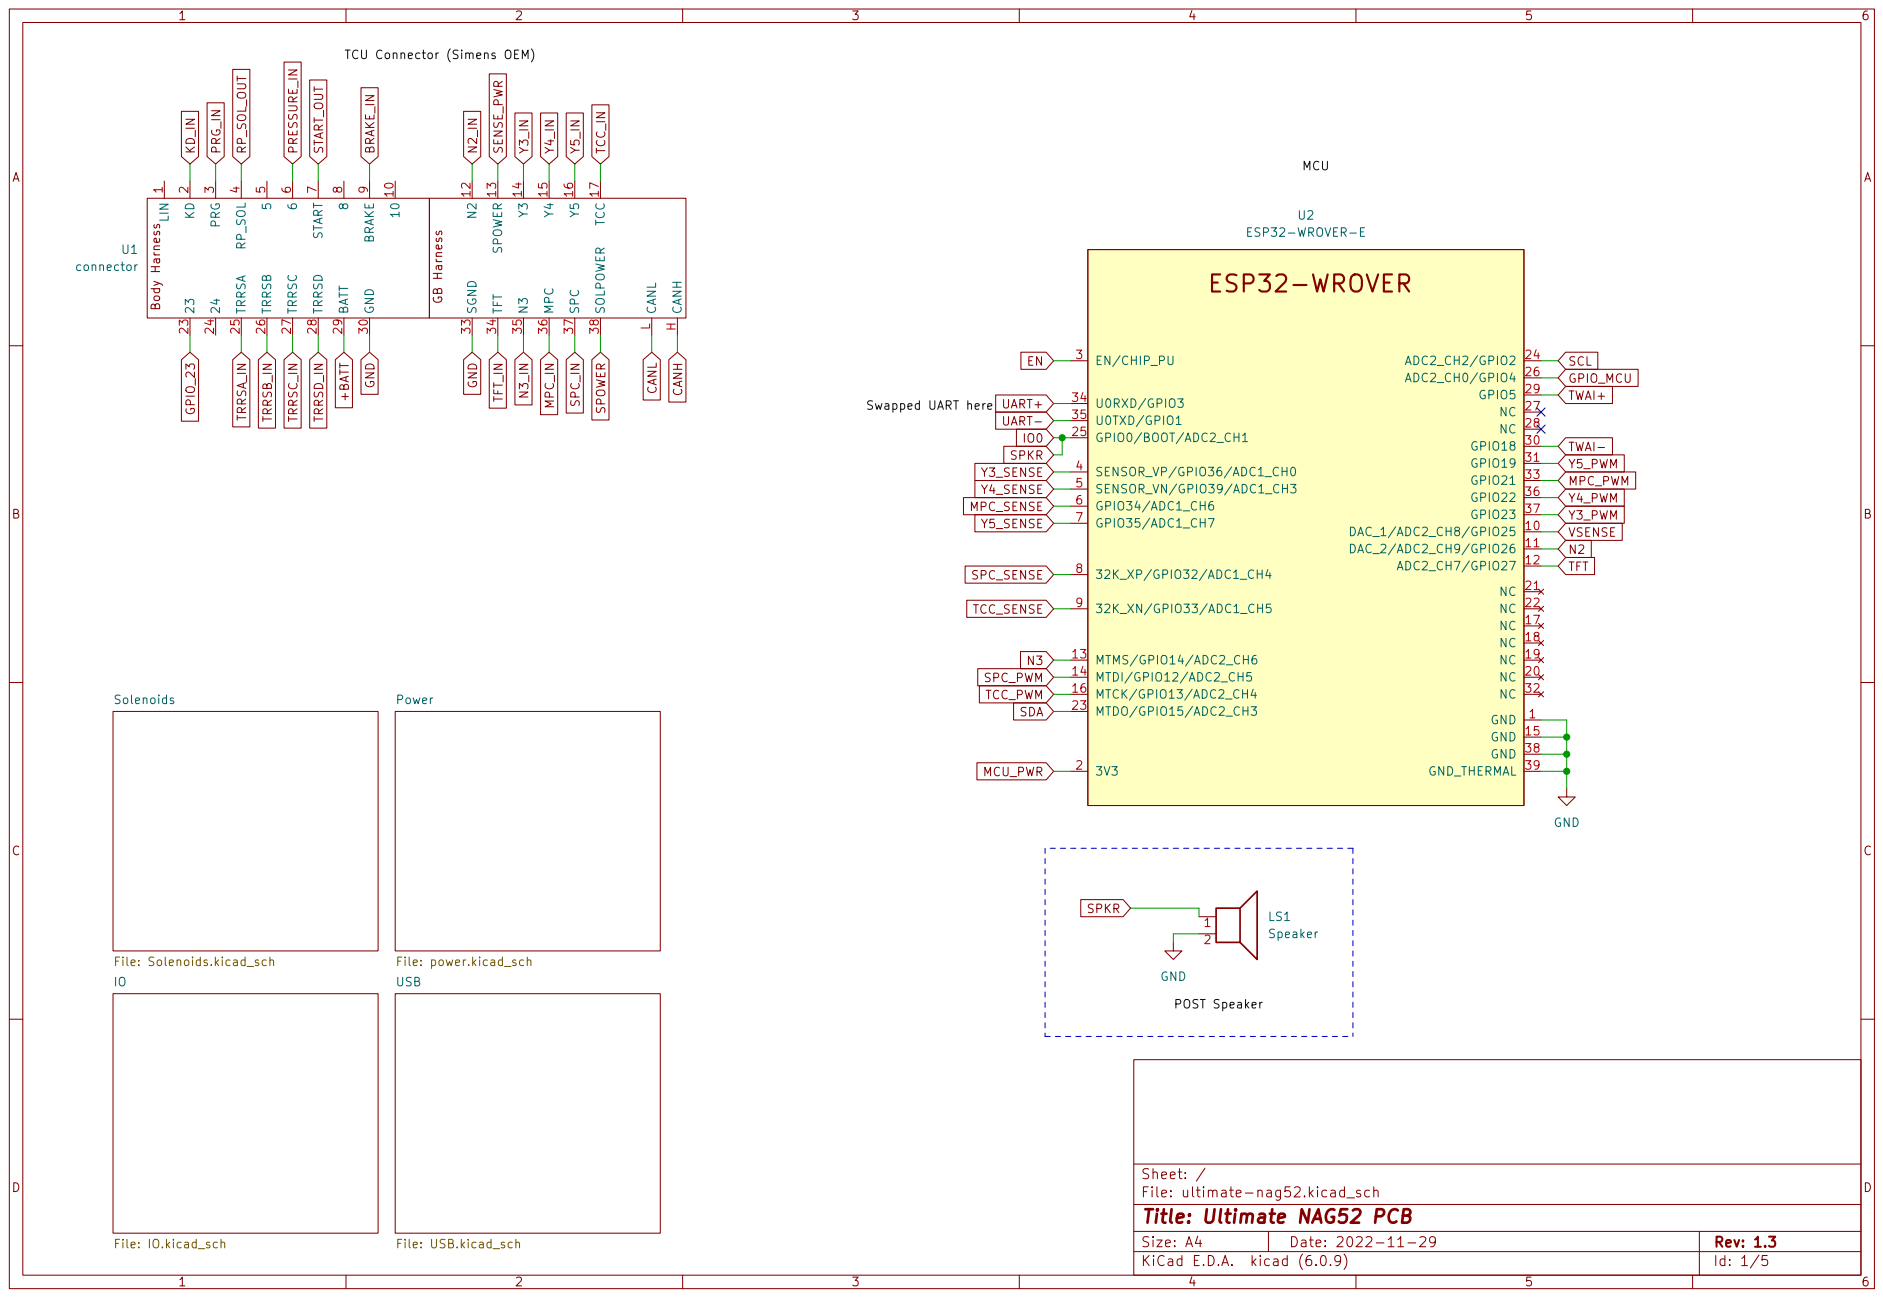
[picture p31: page 1]

TCU Connector (Simens OEM)

2 23 23 24 24 TRRSA 25 TRRSB 26 TRRSC 27 TRRSD 28 BATT 29 PRG

3 GND 30 SGND 33 TFT 34 N3 35 MPC 36 SPC 37 SOLPOWER 38 RP_SOL

File: ultimate-nag52.kicad_sch Sheet: /
Id: 1/5 Title: Ultimate NAG52 PCB

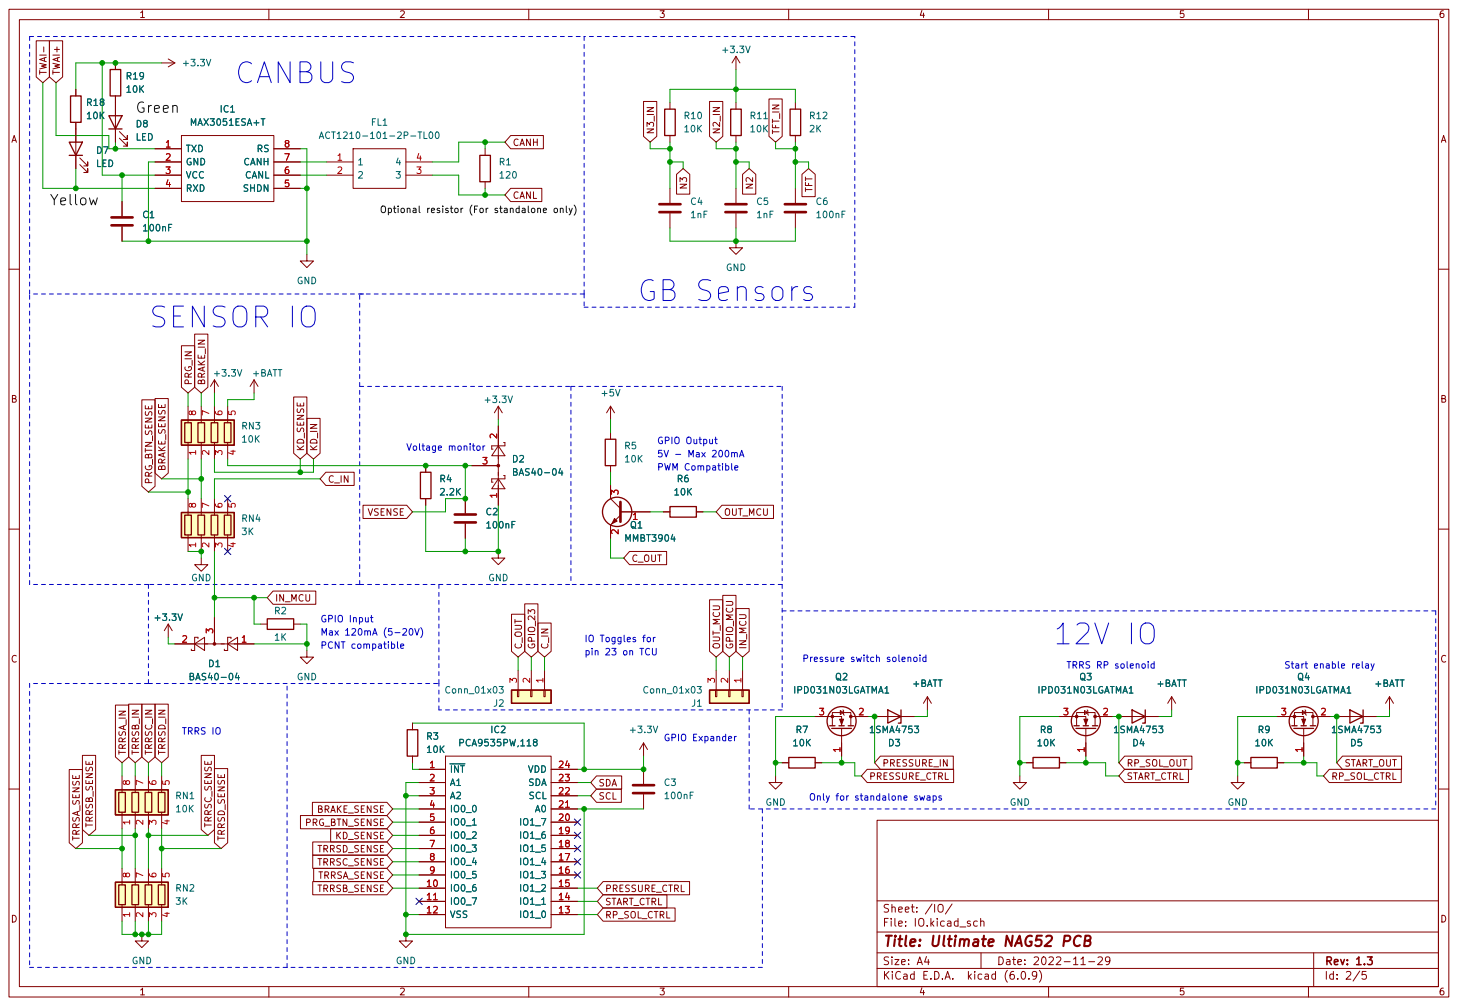
[picture p32: page 2]

Pressure switch solenoid pin 23 on TCU

Only for standalone swaps

File: IO.kicad_sch Sheet: /IO/
Id: 2/5 Title: Ultimate NAG52 PCB

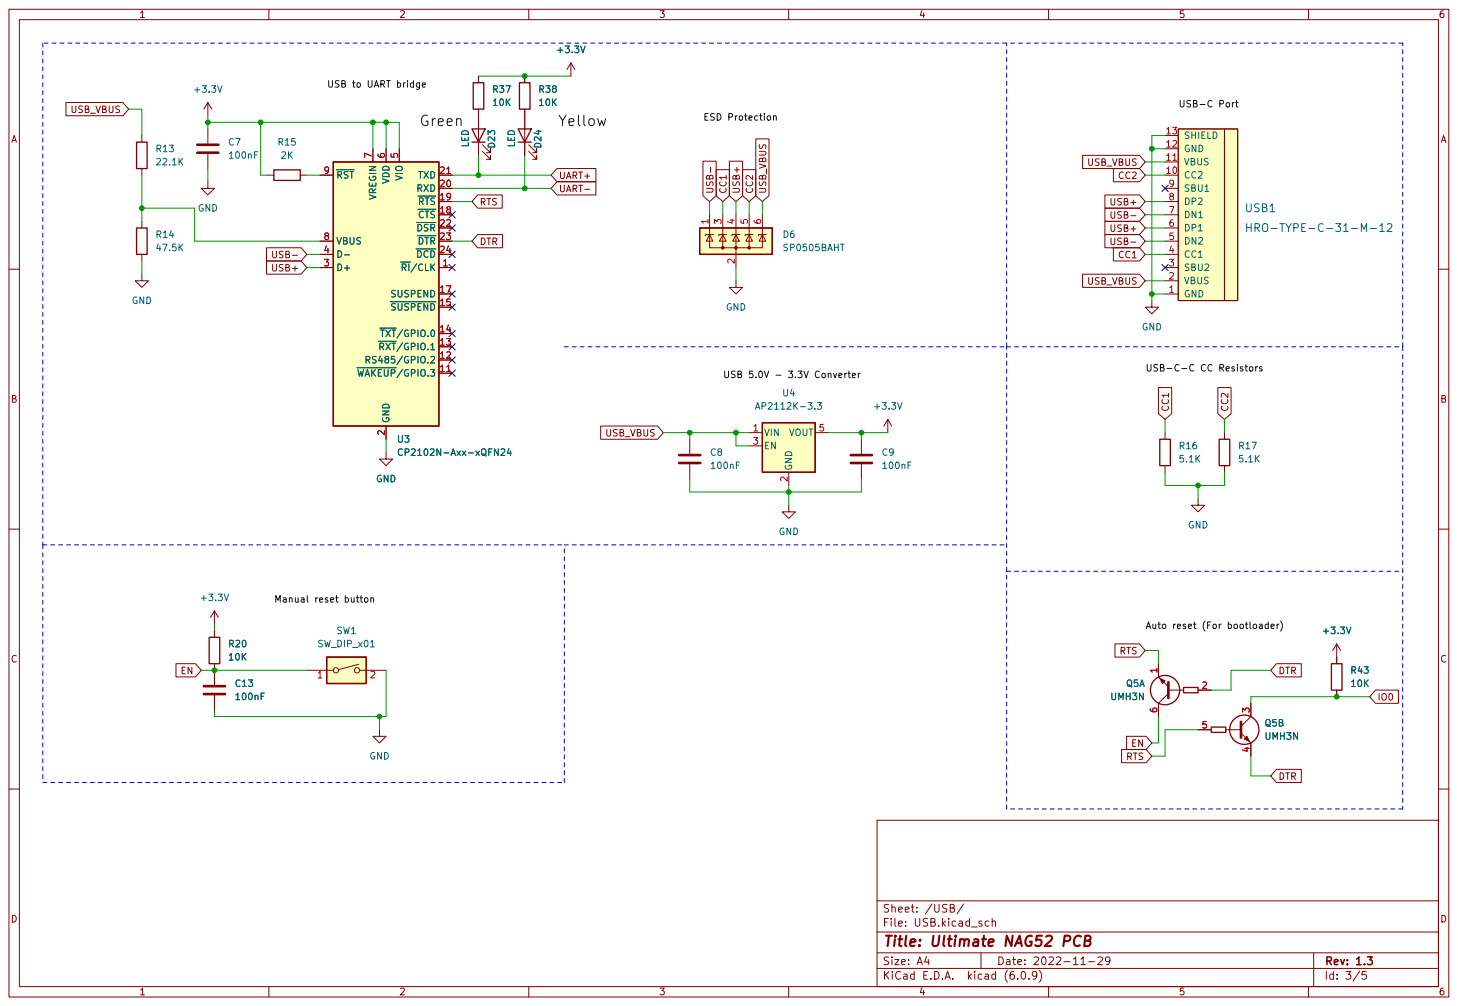
[picture p33: page 3]

2 EN 3 VOUT 5 U4 AP2112K-3.3 +3.3V GND LED D23 LED D24 R37

7 VBUS 8 ~{RST} 9 U3CP2102N-Axx-xQFN24 GND 1 CC2 10 VBUS 11 GND 12 SHIELD 13 VBUS 2 SBU2 3 CC1 4 DN2 5 DP1 6 DN1 7 DP2 8 SBU1 9 USB1

2 RXD 20 TXD 21 ~{DSR}22 ~{DTR}23 ~{DCD}24 D+ 3 D- 4 VIO

File: USB.kicad_sch Sheet: /USB/ C8

Auto reset (For bootloader)

Id: 3/5 Title: Ultimate NAG52 PCB

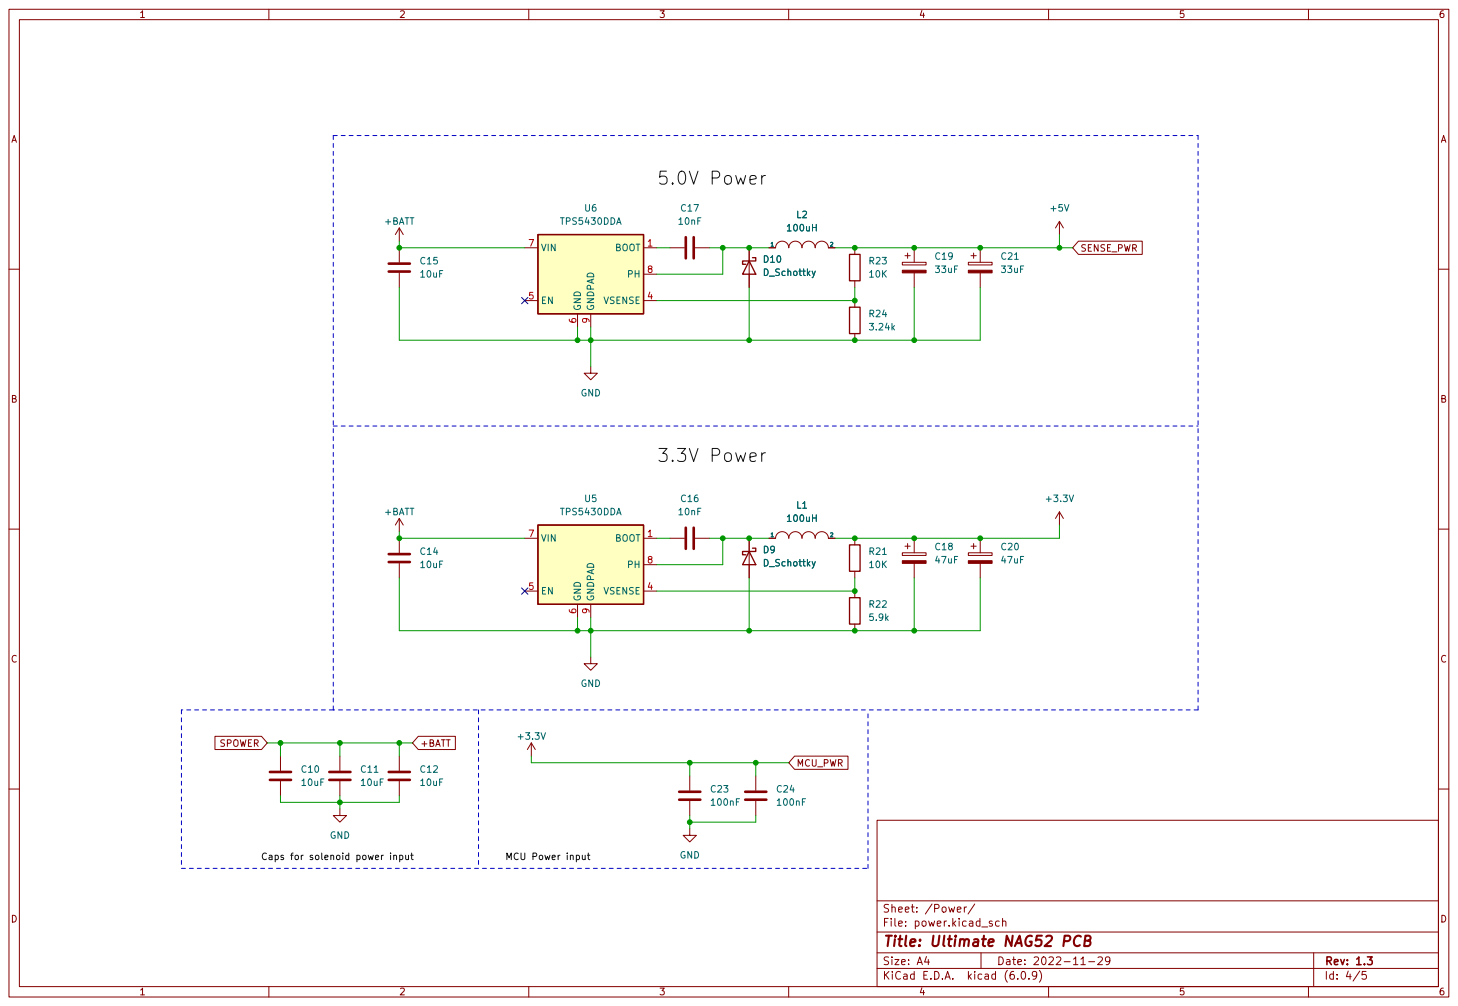
[picture p34: page 4]

10uF C10 | 10uF GND

File: power.kicad_sch Sheet: /Power/ C24

Caps for solenoid power input

Id: 4/5 Title: Ultimate NAG52 PCB

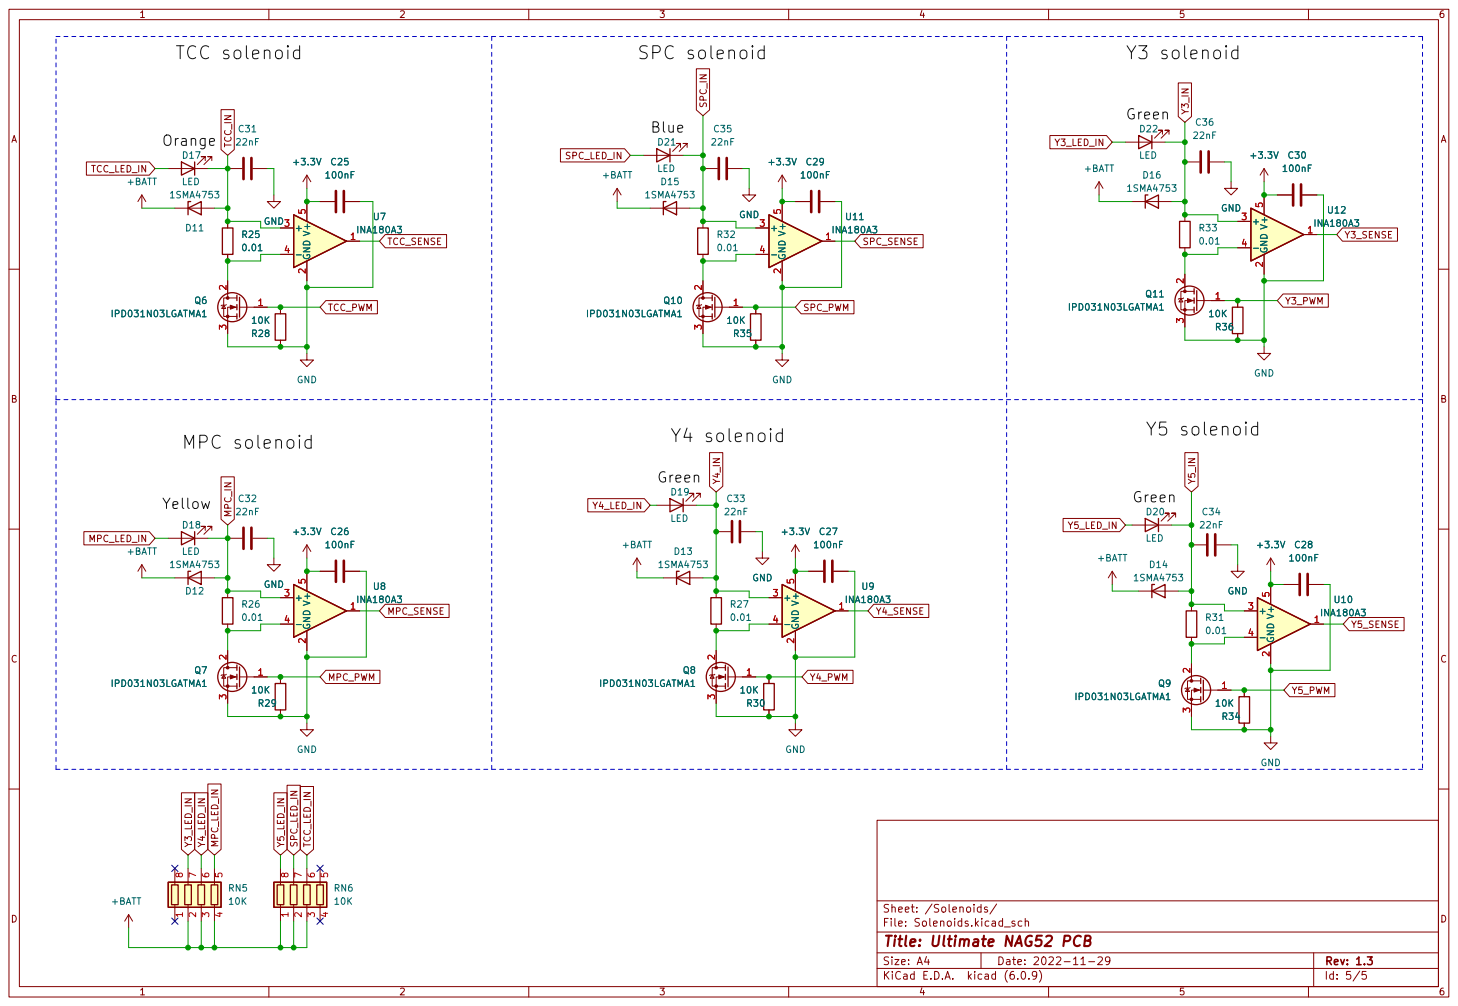
[picture p35: page 5]

File: Solenoids.kicad_sch Sheet: /Solenoids/
Id: 5/5 Title: Ultimate NAG52 PCB
