rnd-ash/ultimate_nag52/PCB/v1.0 (Beta)/schematics_1.0.pdf

# 722.6 TCM Connector ESP32 IO

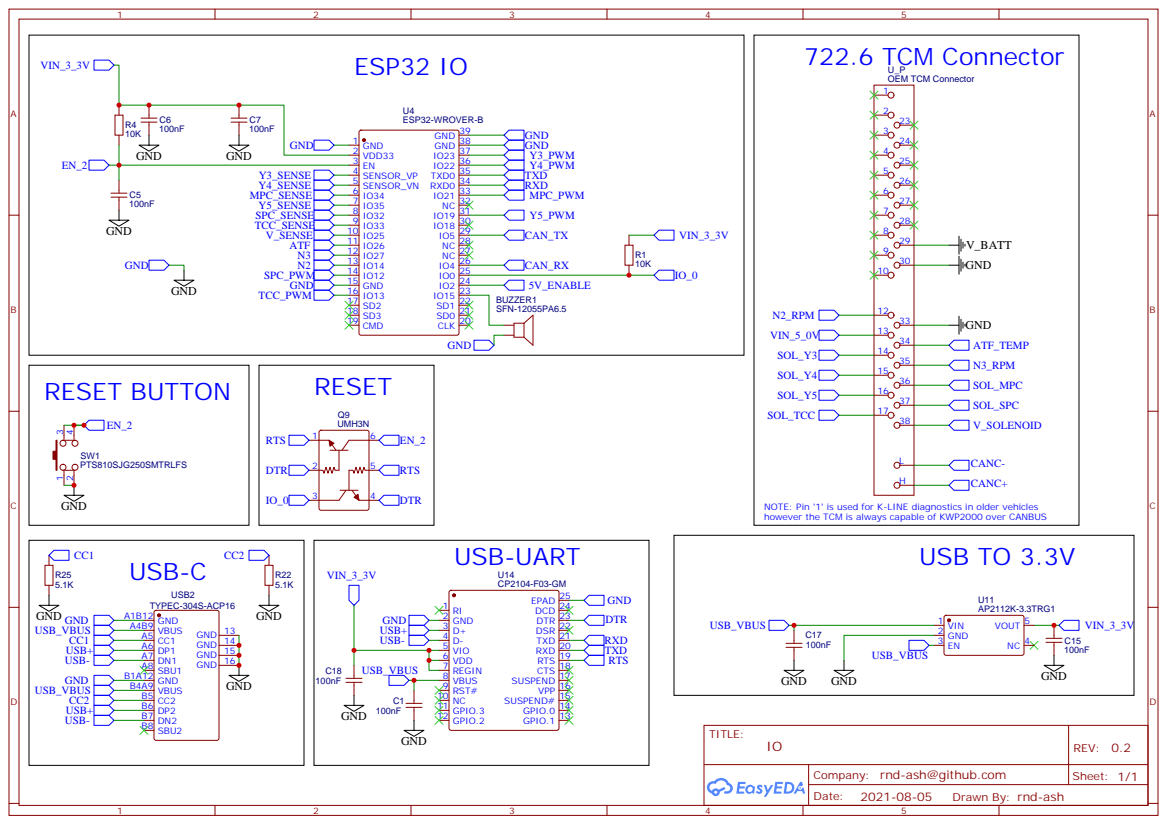
[picture p36: page 1]

NOTE: Pin '1' is used for K-LINE diagnostics in older vehicles
however the TCM is always capable of KWP2000 over CANBUS

Company: rnd-ash@github.com

Drawn By: rnd-ash

# Modulating pressure Shift pressure

# Torque converter

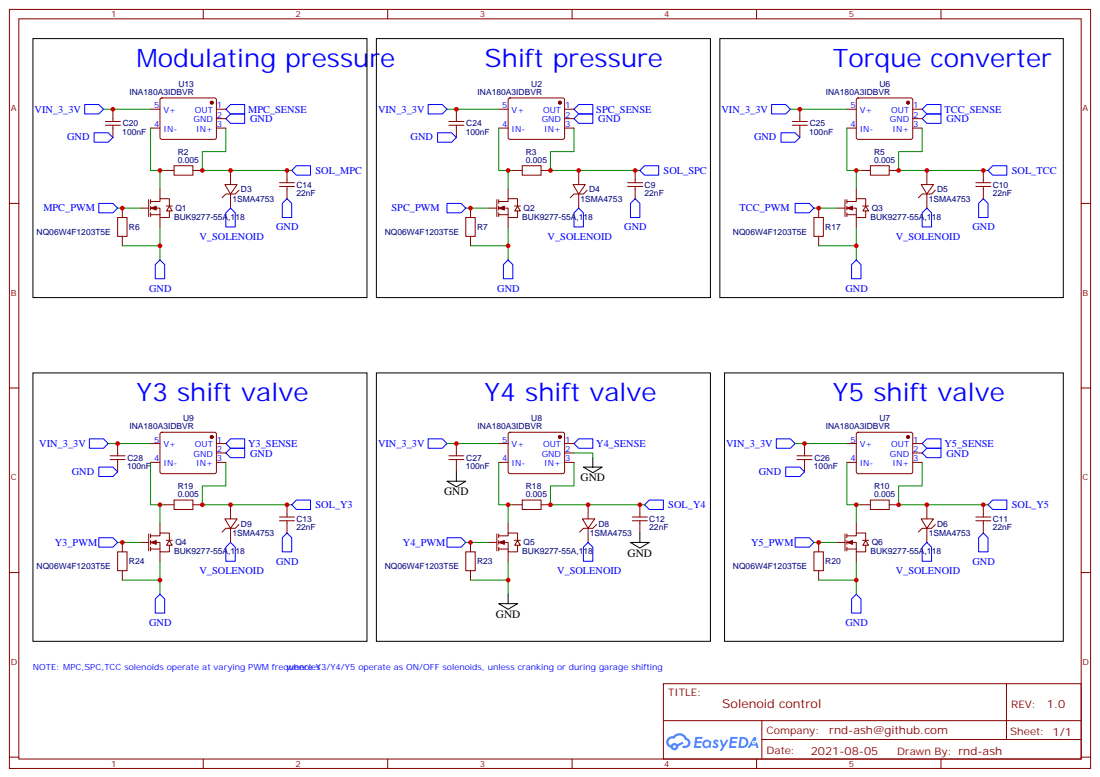
[picture p37: page 2]

NOTE: MPC,SPC,TCC solenoids operate at varying PWM frequencies where Y3/Y4/Y5 operate as ON/OFF solenoids, unless cranking or during garage shifting

3.3V POWER | 5.0V POWER

# BATTERY INPUT

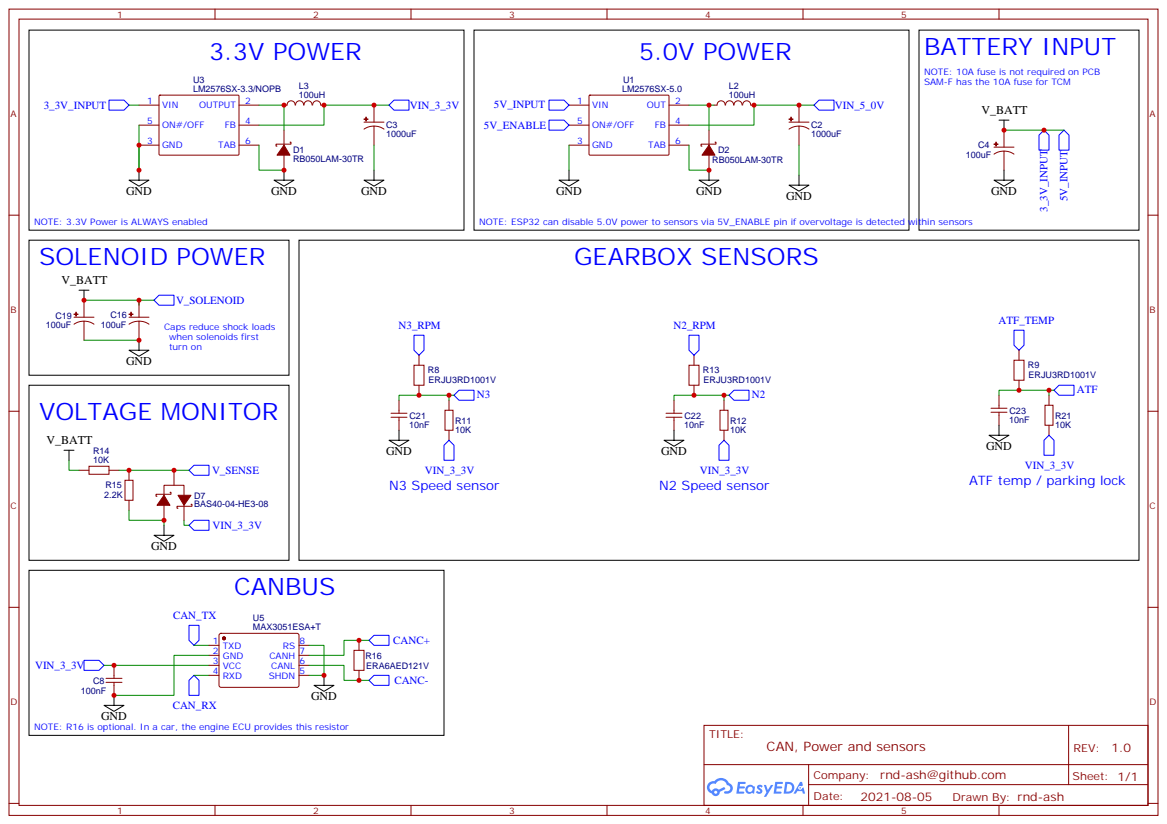
[picture p38: page 3]

NOTE: 10A fuse is not required on PCB
SAM-F has the 10A fuse for TCM

Caps reduce shock loads
when solenoids first
turn on

ATF temp / parking lock

NOTE: R16 is optional. In a car, the engine ECU provides this resistor
