rnd-ash/ultimate_nag52/Addon Boards/1.3 Tcc Zener mod/schematics.pdf

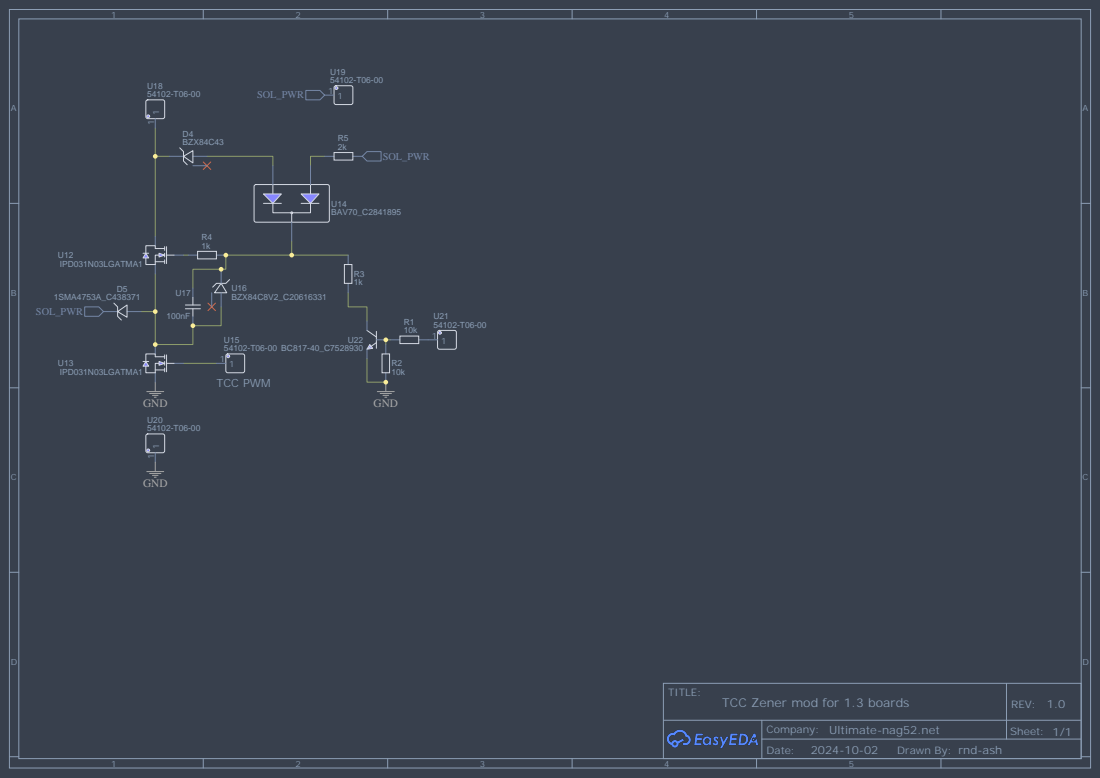
[picture p39: page 1]

Drawn By: rnd-ash
