rnd-ash/ultimate_nag52/PCB/v1.2/schematics_1.2.pdf

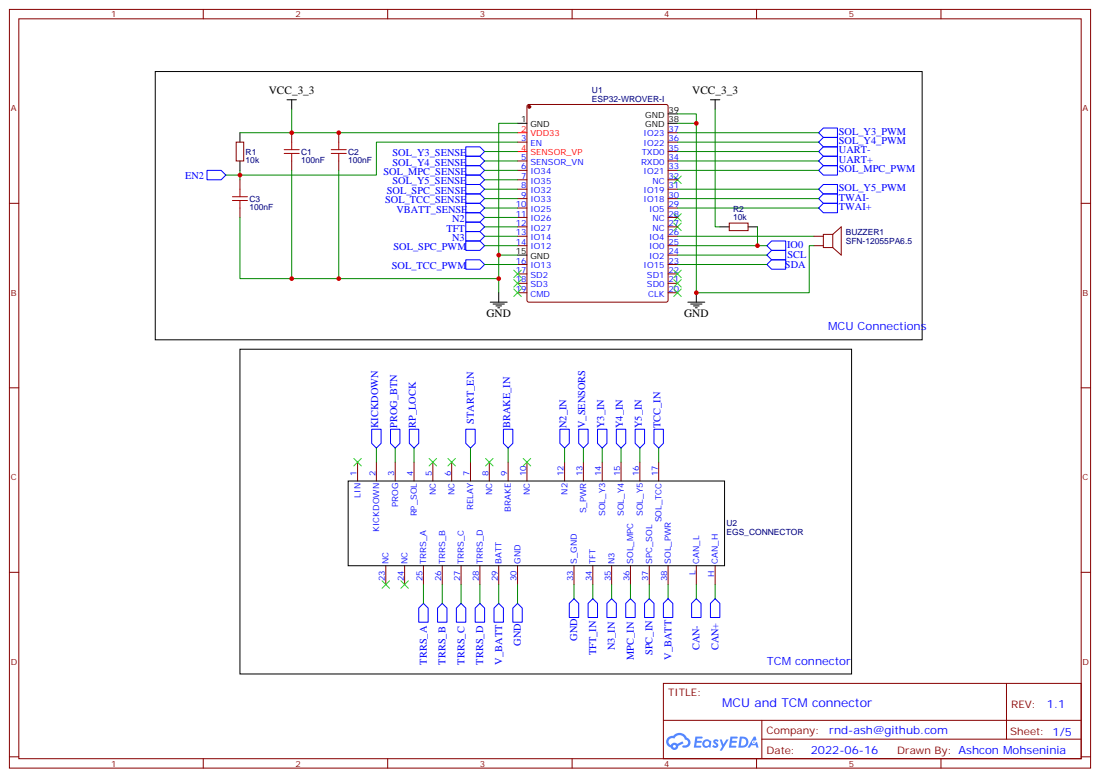
[picture p40: page 1]

Company: rnd-ash@github.com

Drawn By: Ashcon Mohseninia

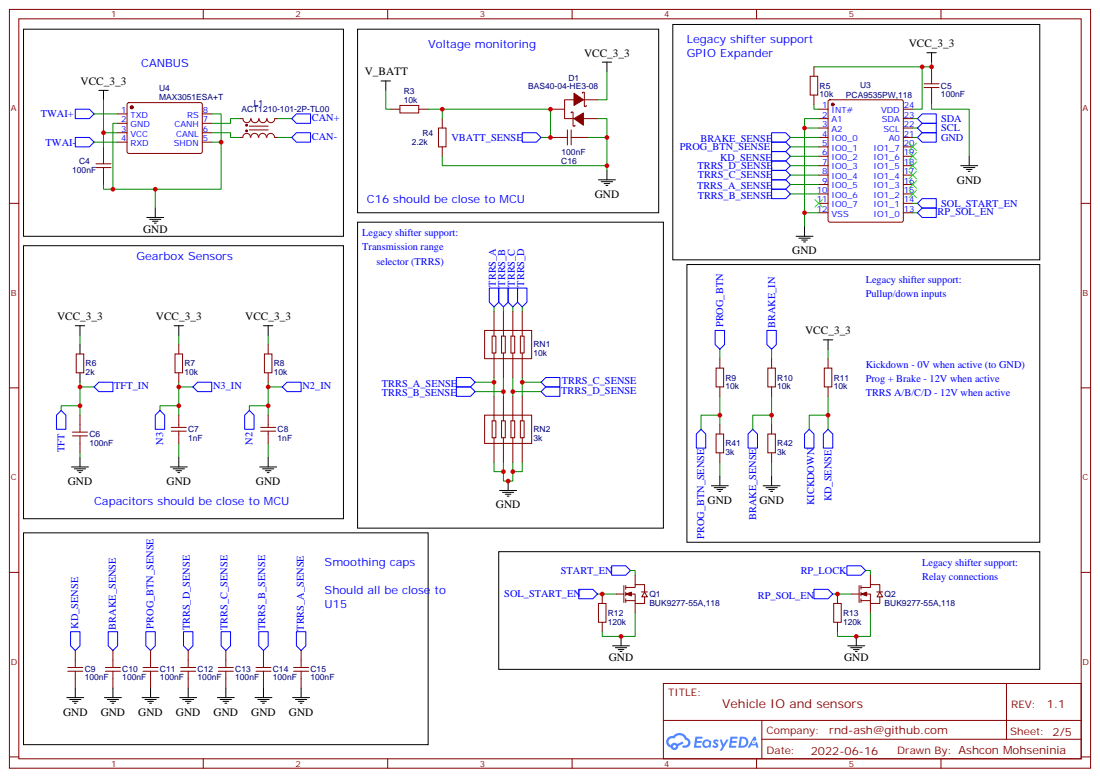
[picture p41: page 2]

C16 should be close to MCU

Kickdown - 0V when active (to GND)
Prog + Brake - 12V when active
TRRS A/B/C/D - 12V when active

GND
Capacitors should be close to MCU

Should all be close to

GND GND GND GND GND GND GND

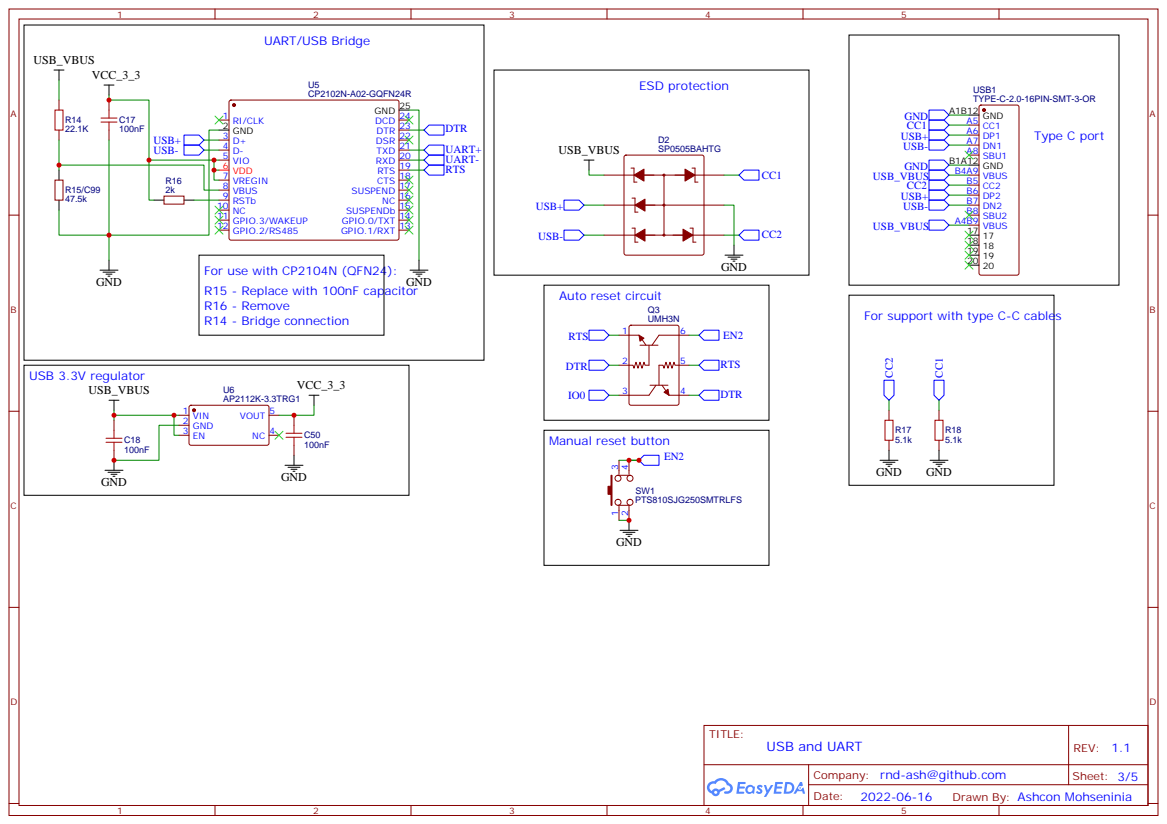
[picture p42: page 3]

For support with type C-C cables

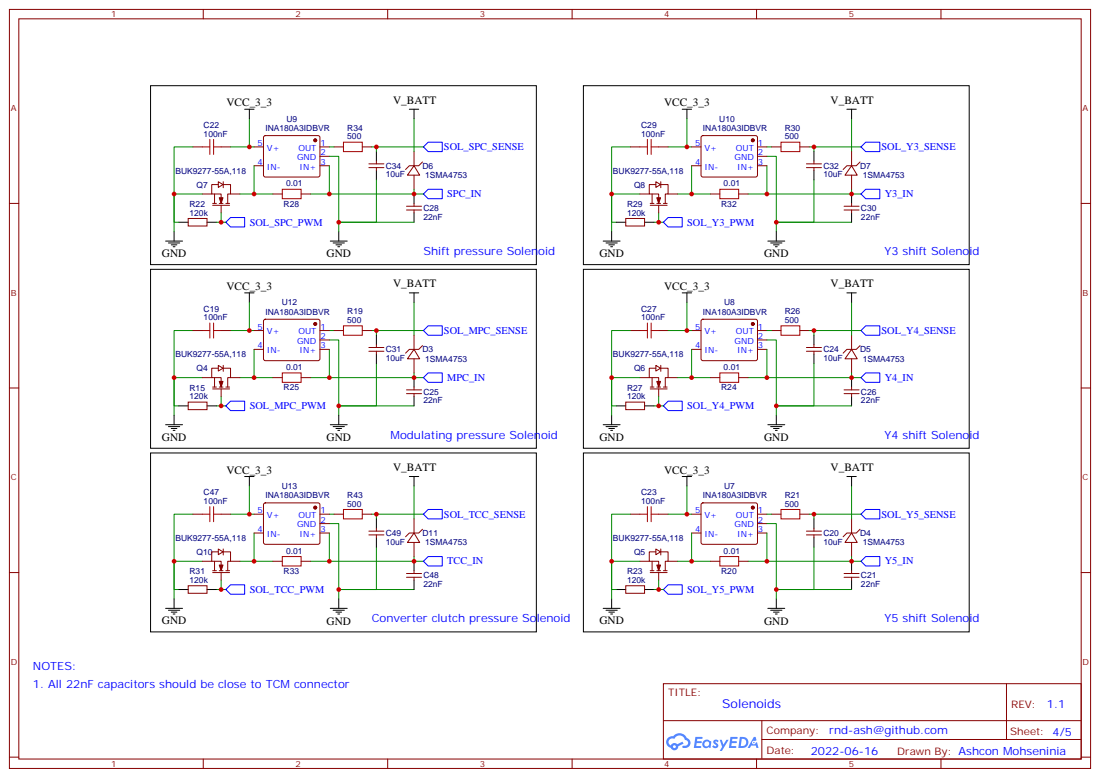
[picture p43: page 4]

Converter clutch pressure Solenoid

NOTES:
1. All 22nF capacitors should be close to TCM connector

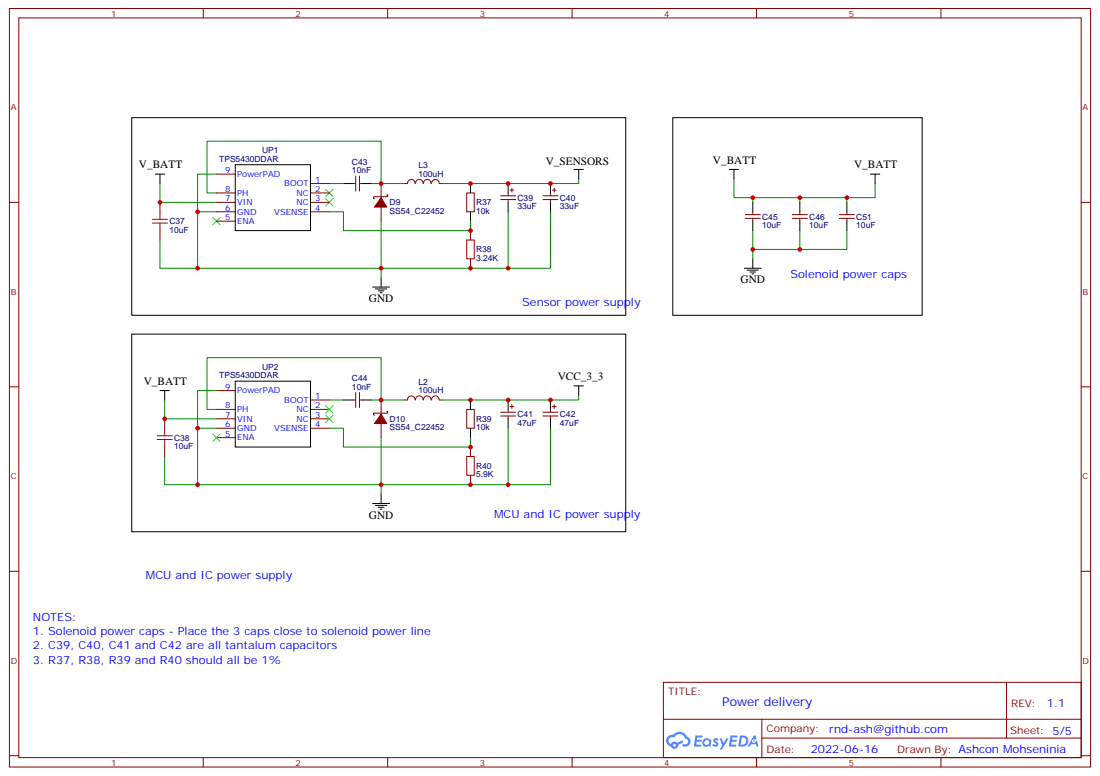
[picture p44: page 5]

MCU and IC power supply

NOTES:
1. Solenoid power caps - Place the 3 caps close to solenoid power line
2. C39, C40, C41 and C42 are all tantalum capacitors
3. R37, R38, R39 and R40 should all be 1%
