rnd-ash/ultimate_nag52/(commit log)

2021-02-19 Add GS Can Frame data
2021-02-19 More can frames
2021-03-05 Add gear display to IC
2021-03-06 Update NAG - Gearbox emulation kinda works
2021-05-25 Add solenoid logic - Working on test PCB
2021-09-27 Add draft schematic for curious people
2022-05-15 Huge changes
    * Add socket CAN support
    * Add J2534 support
    * Increase flashing speed
    * Add solenoid live view (Oscil mode)
    * Fix UI deadlock
2022-06-23 Add new schematics and Gerber!
    [BOM_1.1.csv, P&P_1.1.csv]
2022-07-07 Add V1.2 PCB
    [BOM_1.2.csv, P&P_1.2.csv]
2022-08-03 Add engine RPM to CAN RX data
    [case_v1.blend, v1.FCStd, v2.FCStd]
2022-09-11 Add "Reset to default" map button
2022-09-19 Add reset adaptation map button
2022-09-28 Add query for current FW version
2022-10-12 Add driver trq to diag data
2022-11-30 Add PCB images
2022-12-29 Add V1.3 PCB
    [BOM_1_3.xlsx, P&P_1.3.csv]
2024-05-09 Add V3 case model
    [case_v1.blend, case_v3.stl, v1.FCStd, v2.FCStd]
2024-10-11 Fix 5.1Ohm PN of the 10K resistors
    [BOM_1_3.xlsx]
2024-10-16 Add TCC Zener PCB
    [bom.csv, mount_model.stl, p&p.csv]
